guillemotmoussu/PX222-EIS/PDF/CarnetBord_3_MazzoneMoussu.pdf

### PROJET EIS - PX222

Guillemot MOUSSU et Rémi MAZZONE

2° semestre - 2022-2023

## Table des matières

1 Séance 0 - 21/03/2023 | 3
2 Séance 1 - 05/04/2023 | 4
3 Travail entre les séance 1 et 2 | 8
4 Séance 2 - 18/04/2023 | 10
5 Travail entre les séances 2 et 3 | 12
6 Séance 3 - 03/05/2023 | 14

6.2.2 | Calcul du point de fonctionnement | | 16
6.2.3 | Résistance de la bobine | | 17
6.2.4 | Inductance de la bobine | | 17
6.3 Conclusions | | 18
7 Bibliographie | 19

## Table des gures

1 | Notes séance 0 | | 3
2 | Modélisation de la bobine | | 4
3 | Bode obtenu | | 5
4 | Nyquist obtenu | | 5
5 | Schéma bloc du système | | 6
6 | Amplicateur à AOP | | 6
7 | Modélisation du bloc amplicateur | | 6
8 | Régulateur PD | | 7
9 | Modélisation du bloc régulateur (PD) | | 7
10 | Régulateur PID | | 7
11 | Modélisation complète avec retour (PD) | | 8
12 | Résulat idéal de la simulation | | 9
13 | Schéma LTSPICE de l'amplicateur | | 9
14 | Simulation de l'amplicateur | | 9
15 | Schéma bloc du système, version électronique numérique | | 10
16 | Brochage du STM8s discovery | | 10
17 | Bobine alimentée | | 16
18 | Courbe de l'intensité mesurée en fonction de la distance | | 16
19 | Mesure de la résistance | | 17
20 | Mesure de l'inductance | | 17
21 | Réponse de la bobine | | 17

## 1 Séance 0 - 21/03/2023

1.1 Notes prises au tableau

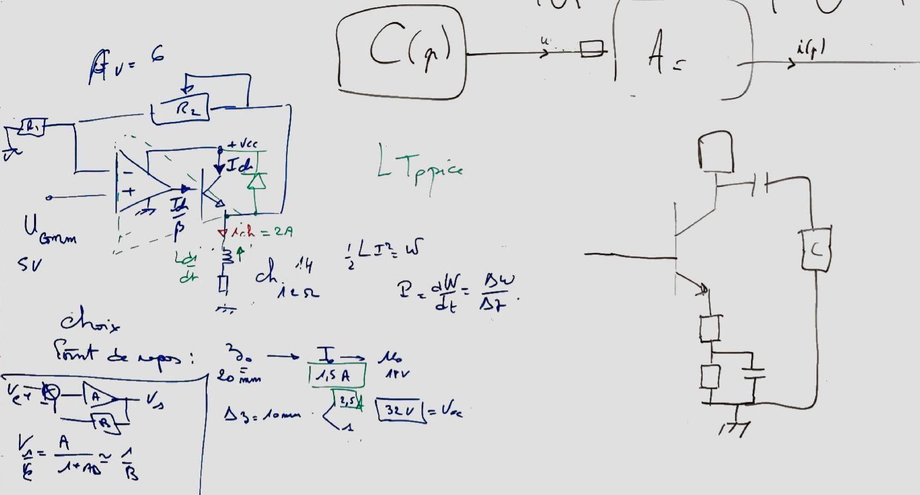
[picture p1: figure]

Figure 1 Notes séance 0

1.2 Idées de plan de recherches

Caractérisation de la bobine : mesure de la résistance et l'inductance de la bobine. Cela
| permettra de modéliser la bobine et de calculer le champ magnétique qu'elle produit
Modélisation de la bobine : utilisation des valeurs mesurées pour construire un modèle
| électrique de la bobine, par exemple en utilisant l'équation de l'inductance d'une bobine. Pour une précision plus élevée, il peut être nécessaire d'inclure d'autres eets tels que la saturation du noyau de la bobine ou la résistance série équivalente

Étude du champ magnétique de la bobine : calcul de la distribution du champ magnétique
| à l'aide d'un logiciel de simulation. Validation des résultats expérimentalement
Choix d'un capteur de distance : choix d'un capteur de distance infrarouge adapté à la
| plage de mesure et à la précision requises. La fréquence de mesure et la plage de mesure peuvent inuencer le résultat

Calibration du capteur de distance : déterminer la relation entre la tension de sortie du
| capteur et la distance de la bille par rapport à la bobine
Conception d'un correcteur : utiliser les données obtenues précédemment pour concevoir un
| correcteur proportionnel-intégral-dérivé (PID) ou un correcteur à avance de phase pour contrôler la position de la bille. C'est la partie clé de ce projet. Le correcteur PID est une méthode de contrôle classique qui est souvent utilisée pour les systèmes de positionnement. Un correcteur à avance de phase peut également être utilisé pour améliorer les performances.

Implémentation du correcteur : test du correcteur via Matlab et Simulink
Étalonnage du système : ajuster les paramètres du correcteur pour atteindre la précision et
| la stabilité requises
Validation du système : tester le système dans diérentes conditions et valider ses perfor-
| mances
Optimisation du système : améliorer le système en optimisant les paramètres du correcteur
| et en utilisant des techniques avancées de contrôle, telles que le contrôle prédictif et le contrôle adaptatif

Il est important de noter que certains des points ont déjà été réalisés lors du premier semestre

## 2 Séance 1 - 05/04/2023

2.1 Reprise des éléments du semestre précédent

Avec Hopkinson, nous avions obtenu un schéma équivalent de la bobine :

ε

φ

R1

R(z)

R0

Figure 2 Modélisation de la bobine

Nous avions trouvé que la fonction de transfert de la bobine est : TBO =

Z
I

=

ki
kz − mp²
Avec les valeurs suivantes :
I0 = 2A, Z0 = 22mm, L1 = 6.73H, α = 2.06, m = 35.8g

ki =

I0 · L1 · α
(1 + α · Z0)

2

, kz =

I

2/0· L1 · α

2
(1 + α · Z0)

3

2.2 Utilisation de Matlab

Nous avons donc notre fonction de transfert. Une idée qui nous est venue est d'adapter les scripts pour utiliser l'outil de M. Mendes que nous avons découvert en TP. Cela devrait nous permettre de calculer notre correcteur. Pour commencer, on a placé nos valeurs dans Matlab et tracé le bode obtenu. Cette étape est présente seulement pour nous faire une idée du système à l'heure actuelle

Code Matlab que nous avons utilisé :

1 | I0 = 2;
2 | Z0 = 22 * 10^-3;
3 | L1 = 6.73;
4 | alpha = 2.06;
5 | ki = (I0 * L1 * alpha) / (1 + alpha * Z0) ^2;
6 | kz = -(I0 ^2 * L1 * alpha ^2) / (1 + alpha * Z0) ^3;
7 | m = 35.8;

8
9 | num = ki ;
10 | den = [(-m) 0 kz];
11 | sys = tf(num,den);

12
13 | figure;
14 | bode(sys)
15 | grid on
16 | figure;
17 | nyquist(sys)
18 | grid on

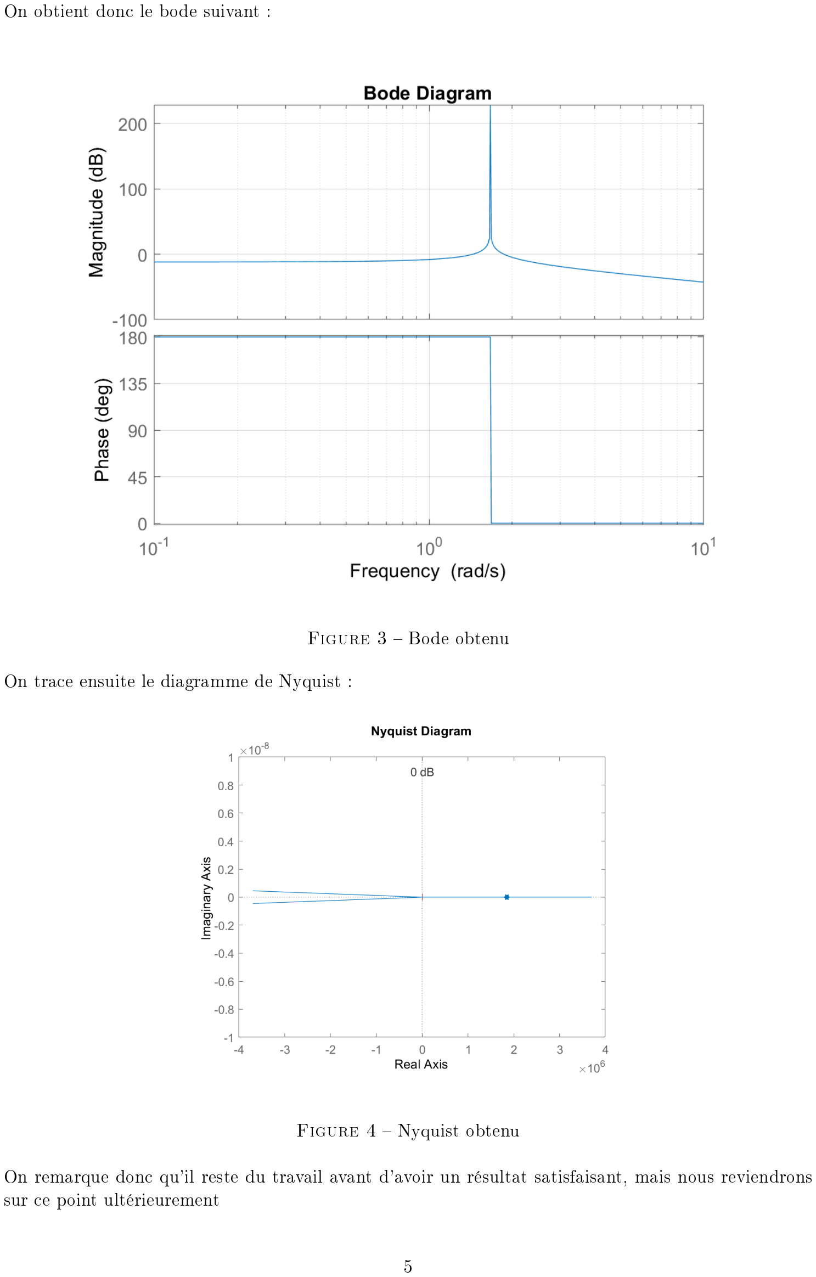
[picture p2: page 5]

On obtient donc le bode suivant :

Figure 3 Bode obtenu

On trace ensuite le diagramme de Nyquist :

Figure 4 Nyquist obtenu

On remarque donc qu'il reste du travail avant d'avoir un résultat satisfaisant, mais nous reviendrons sur ce point ultérieurement

2.3 Modélisation point par point du système

L'objectif est de réaliser un circuit correspondant à ce schéma bloc :

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
X | Y

B

Ym

Figure 5 Schéma bloc du système

### 2.3.1 Modélisation de l'amplicateur

Nous avons en sortie d'un STM8 un signal de 5V, nous voulons que la bobine soit alimentée en 30V. Pour cela on utilise un amplicateur à AOP, en série avec un transistor bipolaire. On a le schéma classique d'un amplicateur à AOP :

A

U | X

−

+

R1
U

R2

X

Figure 6 Amplicateur à AOP

Si on ajoute le transistor et la bobine au schéma, cela nous donne :

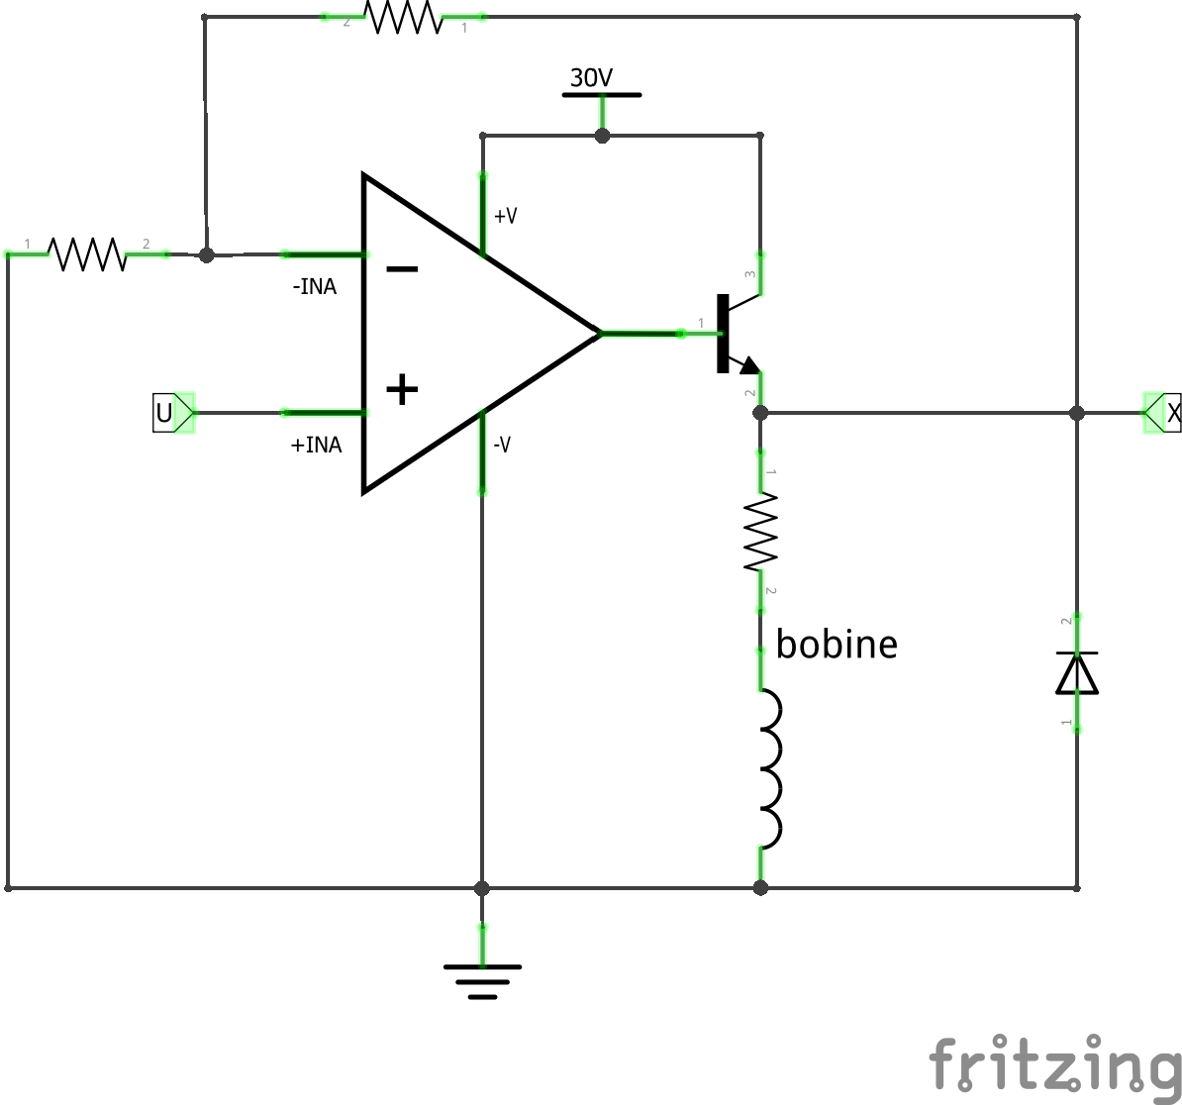
[picture p3: figure]

Figure 7 Modélisation du bloc amplicateur

### 2.3.2 Modélisation d'un régulateur PD

On a le schéma classique d'un régulateur PD :

R

ε | U

−

+

R1

ε

C
R2

U

Figure 8 Régulateur PD

Si on donne le schéma complet de ce bloc, cela nous donne :

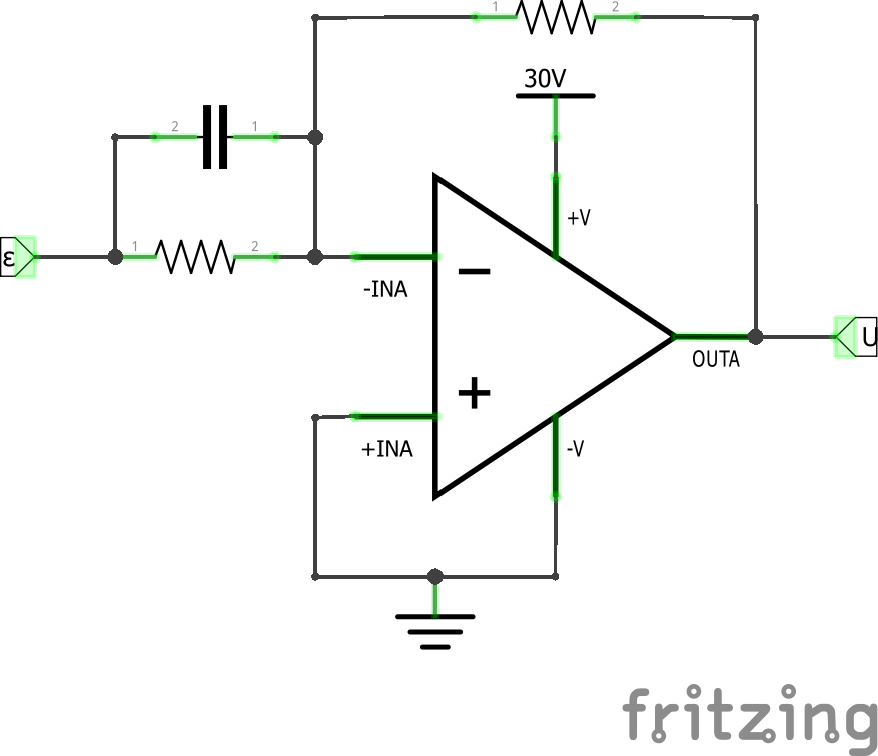
[picture p4: figure]

Figure 9 Modélisation du bloc régulateur (PD)

### 2.3.3 Modélisation d'un régulateur PID

Dans le cas où l'on souhaite nalement modéliser un régulateur PID, on doit ajouter un condensateur en parallèle de notre résistance :

−

+

R1

ε

C1 | R2

C2

U

Figure 10 Régulateur PID

### 2.3.4 Modélisation du système complet (PD)

On choisit le régulateur PD pour représenter le système complet. On a vu qu'il sura d'ajouter une capacité pour passer à un régulateur PID au besoin. On repère bien les blocs comparateur, amplicateur (A), régulateur (R) et capteur (B)

a

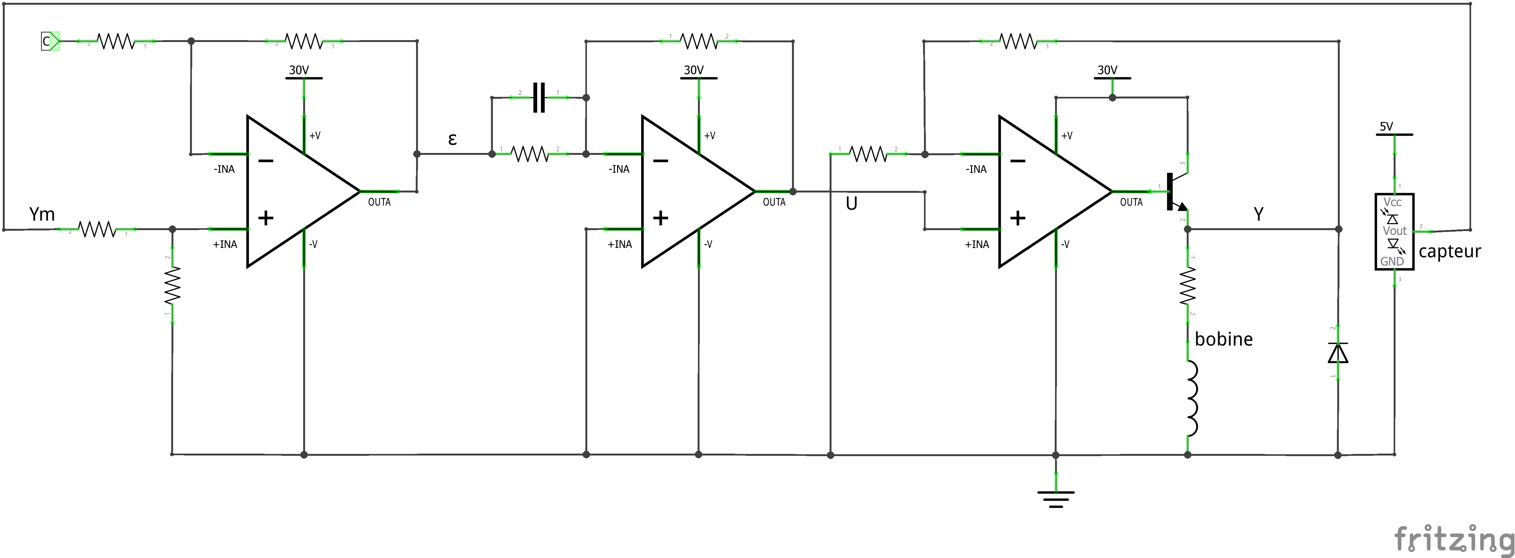
[picture p5: figure]

Figure 11 Modélisation complète avec retour (PD)

2.4 Conclusions pour cette séance

On commence à avoir des pistes intéressantes. Les schémas que nous avons réalisés vont nous permettre de se faire une idée du système à concevoir, et nous avons perçu l'importance d'utiliser Matlab pour nous aider dans nos calculs

## 3 Travail entre les séance 1 et 2

3.1 Correction des éléments de la séance précédente

Nous avions manqué de temps pour terminer comme nous le souhaitions certains points de la séance précédente. Nous avons travaillé sur les points suivants :

### 3.1.1 Matlab

Pour plus de détails se référer à la section 2.2

Les schémas avaient étés rendus avec Octave, mais après comparaison des rendus, ceux de Matbab donnent d'autres résultats. Les gures 3 et 4 ont donc été mises à jour

### 3.1.2 Modélisation point par point du système

Pour plus de détails se référer à la section 2.3

La gure 5 est maintenant rendue en LATEX

Pour plus de clarté, les points 2.3.1, 2.3.2 et 2.3.3 ont été repris. Les gures 6, 8 et 10 ont été reprises en LATEX. Les gures 7 et 9 ont été reprises sur Fritzing, avec un bloc AOP mis à jour

Le point 2.3.4 a été séparé plus plus de clarté. La gure 11 y a été ajoutée

3.2 Simulation de l'amplicateur

On veut donc simuler notre bloc amplicateur. Dans l'idéal on devrait avoir le graphique suivant :

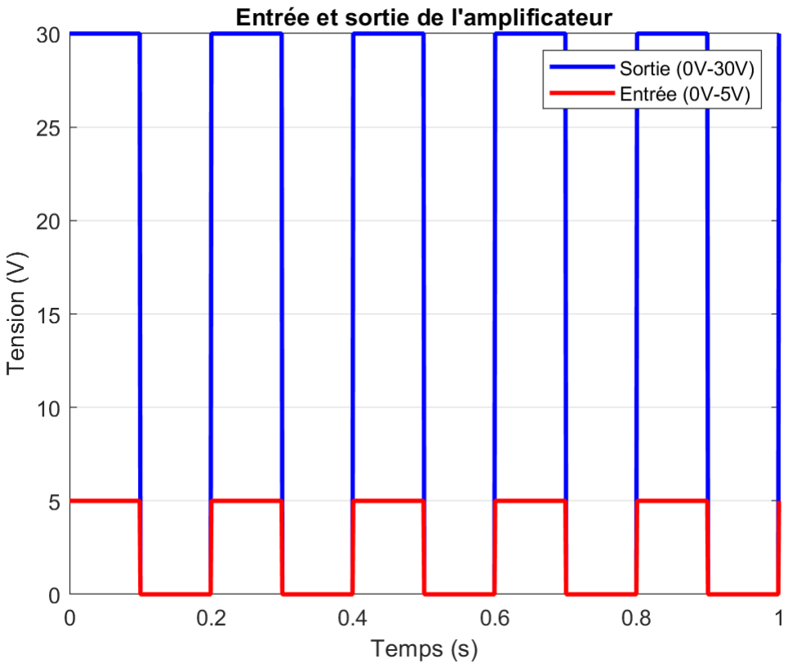
[picture p6: figure]

Figure 12 Résulat idéal de la simulation

On rentre donc le modèle suivant dans LTSPICE :

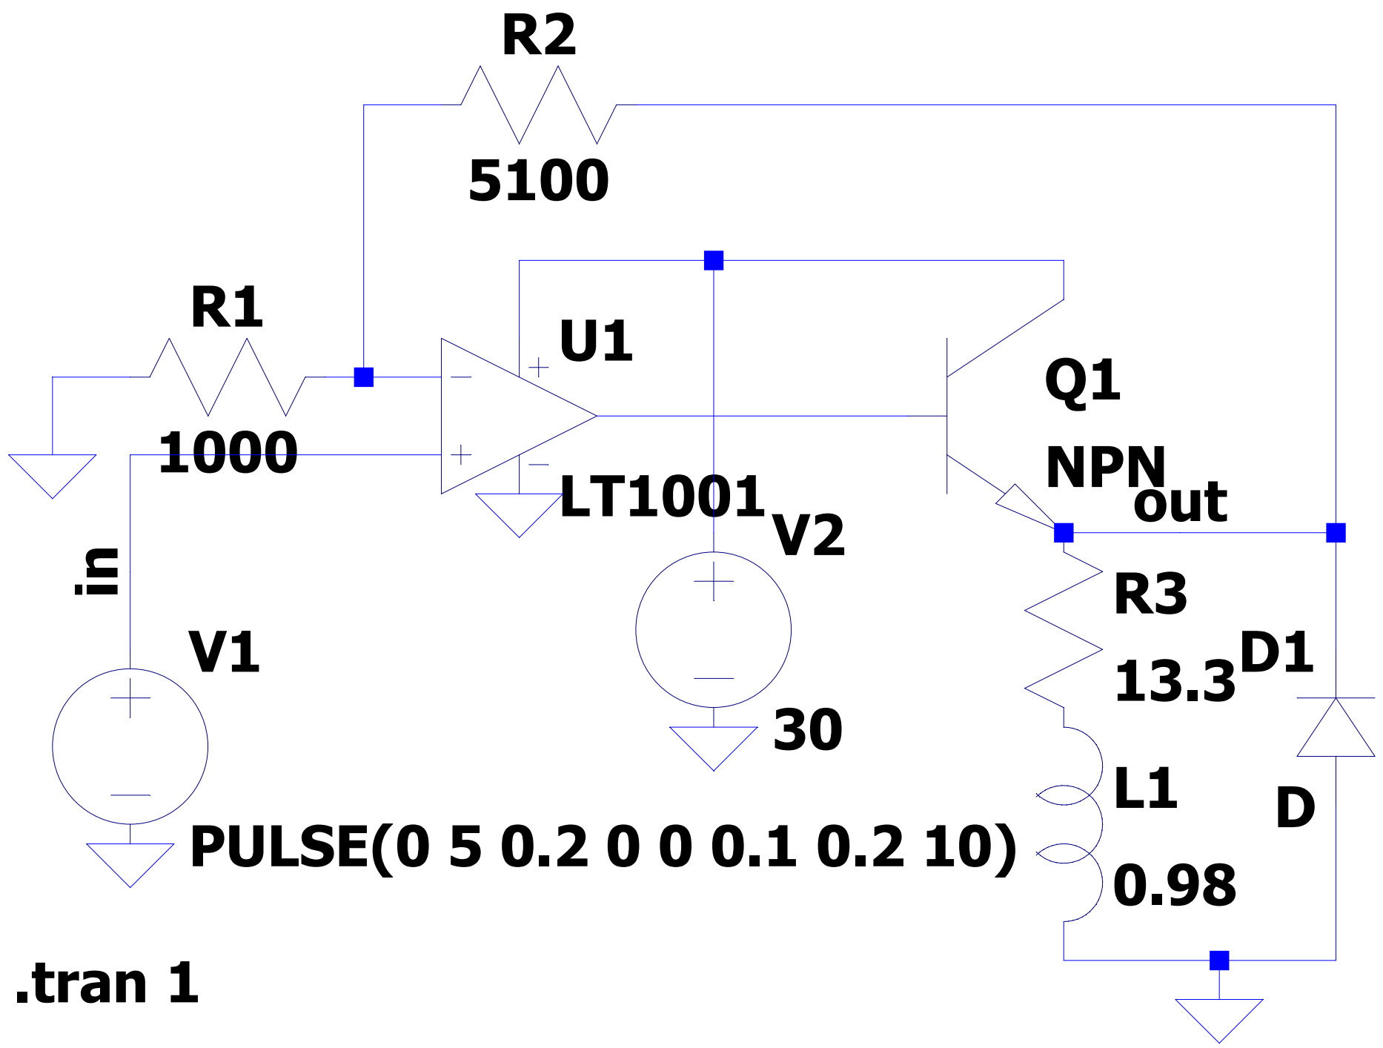
[picture p7: figure]

Figure 13 Schéma LTSPICE de l'amplicateur

Et on obtient le résultat suivant :

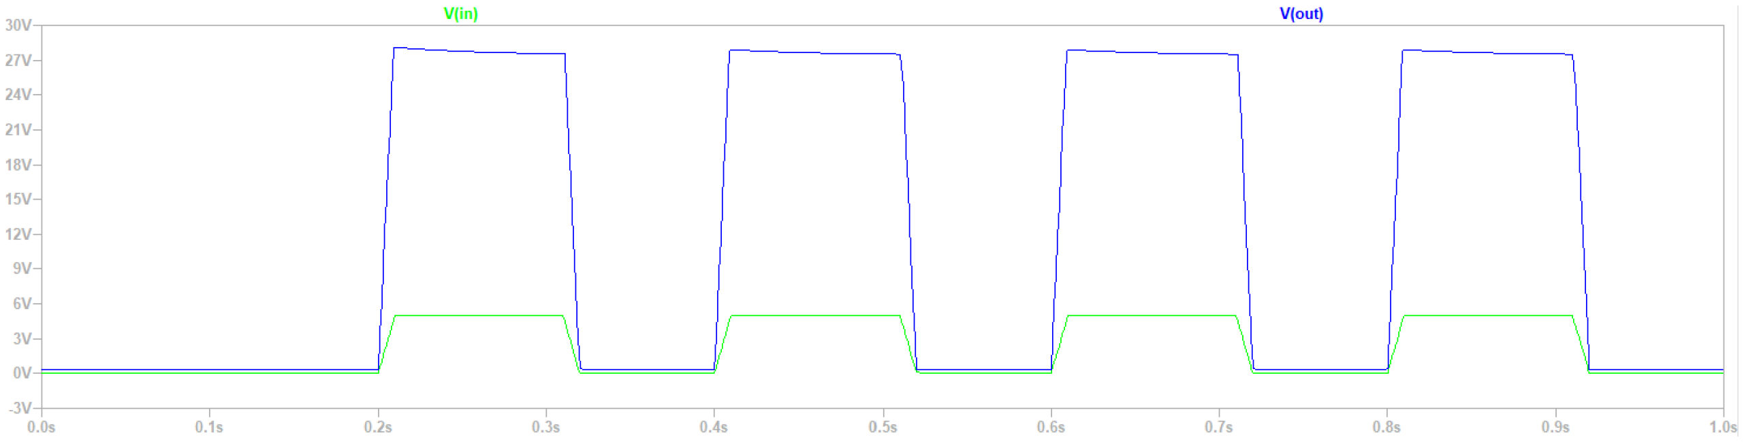
[picture p8: figure]

Figure 14 Simulation de l'amplicateur

### Remarques :

On a utilisé un AOP quelconque (le LT1001 en l'occurence)
On a utilisé les mesures de la bobine du S1 (R = 13.3Ω et L = 0.98H)
On a utilisé un transistor quelconque
On remarque que la simulation correspond au modèle théorique voulu. C'est bon signe pour la suite, il reste à le tester avec des composants réels

## 4 Séance 2 - 18/04/2023

4.1 Réexion sur la numérisation du correcteur

On va donc chercher à numériser la partie correcteur. Cela correspond aux éléments suivants sur notre schéma bloc :

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
X | Y

B

Ym

Figure 15 Schéma bloc du système, version électronique numérique

On utilisera un STM8s pour la numérisation. On compte utiliser un port analog input pour l'entrée venant du capteur, et un port I/O piloté en PWM pour la sortie U

4.2 Prise en main du STM8s

On a le brochage du STM8 :

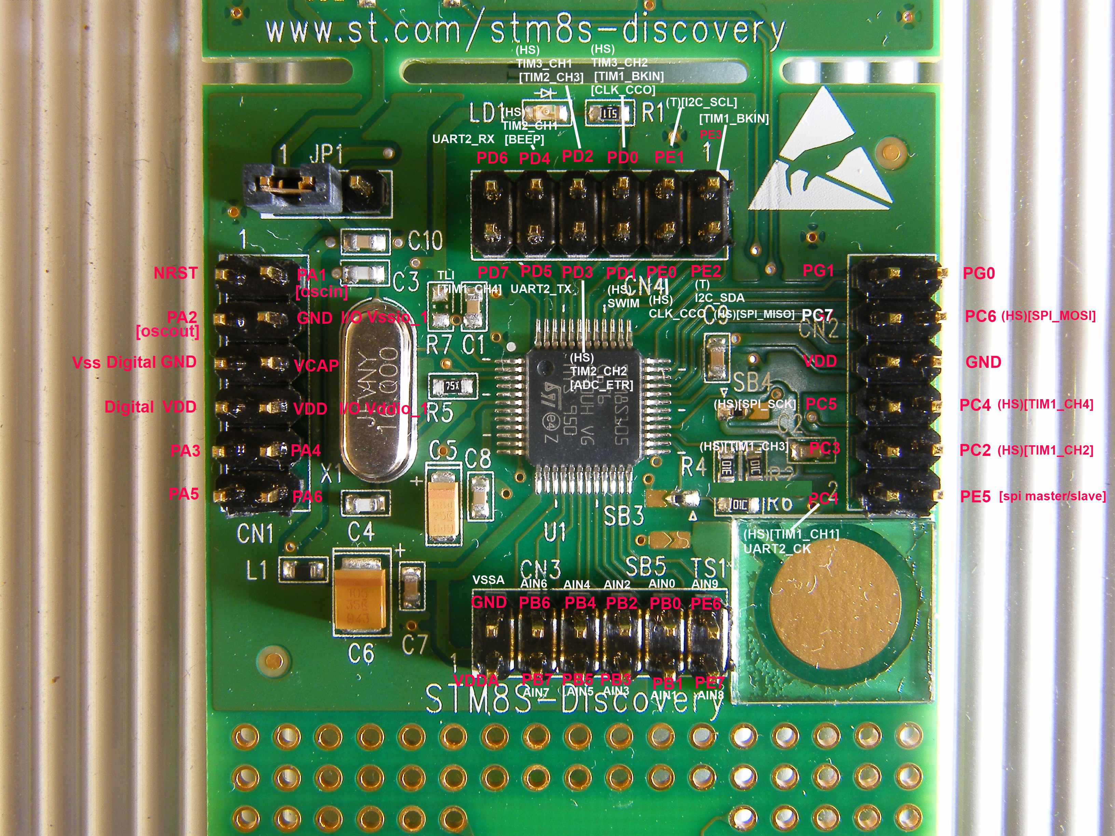
[picture p9: figure]

Figure 16 Brochage du STM8s discovery

On dénit pour le moment qu'on utilise le port B0 (Analog 0) pour l'entrée et le port G0 pour la sortie (I/O classique)

4.3 Premier essai de code

Par la suite, nous avons cherché à faire fonctionner la carte, en vue de pouvoir faire nos mesures. On se base sur l'exemple fourni par ST permettant de faire clignoter la LED installée sur la carte : chiers du projet. (https://www.st.com/en/embedded-software/stsw-stm8023.html) Ce projet est écrit en C, compilé à l'aide de Cosmic. On conrme que cela fonctionne

4.4 Essais avec Arduino

An de pouvoir communiquer, notemment via la communication série avec la carte, on a essayé d'ins-taller les librairies nécessaires sur l'Arduino IDE. On se base sur le travail de Michael Mayer pour le

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

Le but de ce code est de réaliser les actions suivantes :
Toutes les 10ms, une interruption se produit et déclenche la conversion ADC, et attend la n de la conversion
La valeur de la conversion est stockée dans le registre TIM4_ARR, qui est utilisé pour dénir la période du timer 4
En tant que tel, on peut ensuite utiliser un oscilloscope pour acher la tension mesurée

Nous n'avons pas eu le temps de rééchir au code, et nous ne savons pas encore si nous préfèrerons le faire en assembleur ou en C

4.6 Conclusions pour cette séance

Si nous avons pu prendre en main la carte et rééchir à l'implémentation du correcteur numériquement, les nombreux freins (problèmes logiciels, logiciels peu ergonomiques...) ont été un frein et nous n'avons pas eu le temps de faire beaucoup de choses. Il sera donc important de travailler entre les deux prochaines séances pour avancer, tant sur la partie analogique, que la partie numérique

## 5 Travail entre les séances 2 et 3

5.1 Lecture d'une entrée analogique

Des recherches sur internet nous ont permis de trouver les tutoriels suivants : Tutoriel de CircuitDigest pour ADC (https://circuitdigest.com/microcontroller-projects/adc-on-stm8s-using-c-compiler-reading-multiple-adc-values-and-displaying-on-lcd) et Tutoriel de CircuitDigest pour la lecture série. (https://circuitdigest.com/microcontroller-projects/serial-monitor-on-stm8s-using-cosmic-and-stvd) On utilise le code de ces deux tutoriels pour produire le programme suivant :

#include "STM8S.h"

#include "stm8s103_adc.h"

#include "stm8s103_serial.h"

void main()

{
| // Declarations de variables unsigned int ADC_value_1 = 0; int ADC_voltage_1 = 0;
| CLK_PeripheralClockConfig(CLK_PERIPHERAL_ADC, ENABLE); // Activer l'horloge peripherique pour l'ADC GPIO_Init(GPIOB, GPIO_PIN_0, GPIO_MODE_IN_FL_IT); // Initialiser le pin PB0 en entree
| Serial_begin(9600); Serial_print_string("Bonjour !"); Serial_newline(); delay_ms(5000);
| while (1)

{
| ADC_value_1 = ADC_Read(AIN2); ADC_voltage_1 = ADC_value_1 * (2.933); //(3000/1023 =~ 2.933) Serial_print_string("B0: "); Serial_print_string(ADC_value_1); Serial_print_string(" -> "); Serial_print_string(ADC_voltage_1); Serial_print_string(" mV"); Serial_newline(); delay_ms(500);

}

}

On aura donc à priori besoin des chiers suivants : Fichiers de base (https://github.com/CircuitDigest/STM8S103F3_SPL)
Fichier Serial.h (https://github.com/CircuitDigest/STM8S103F3_SPL/blob/master/stm8s103%20Libraries/stm8s103_Serial.h)
Fichier ADC.h (https://github.com/CircuitDigest/STM8S103F3_SPL/blob/master/inc/stm8s103_ADC.h)

5.2 Génération d'un signal PWM

### 5.2.1 Code

Des recherches sur internet nous ont permis de trouver le tutoriel suivant : Tutoriel de CircuitDigest. (https://circuitdigest.com/microcontroller-projects/pulse-width-modulation-pwm-with-stm8-using-cosmic-c-and-stvd) On en retire le code suivant :

#include "STM8S.h"

void delay_ms(int ms)

{
int i;
int j;
| for (i = 0; i <= ms; i++) { for (j = 0; j < 120; j++) {_asm("nop");}

}

}

void main(void)

{
| GPIO_DeInit(GPIOD); TIM2_DeInit(); GPIO_Init(GPIOD, GPIO_PIN_4, GPIO_MODE_OUT_PP_HIGH_FAST); TIM2_OC1Init(TIM2_OCMODE_PWM1, TIM2_OUTPUTSTATE_ENABLE, 1000, TIM2_OCPOLARITY_HIGH); TIM2_TimeBaseInit(TIM2_PRESCALER_1, 500); TIM2_Cmd(ENABLE); while (TRUE)

{
| signed int pwm_duty = 500; TIM2_SetCompare1(pwm_duty);

}

}

### 5.2.2 Description du code

Dans la fonction main, les fonctions de conguration et d'initialisation suivantes sont appelées :
GPIO_DeInit(GPIOD) : réinitialisation des paramètres du port D
TIM2_DeInit() : réinitialisation du Timer 2
{GPIO_Init(GPIOD, GPIO_PIN_4, GPIO_MODE_OUT_PP_HIGH_FAST) : conguration de la broche PD4
| en sortie push-pull avec une vitesse élevée
TIM2_OC1Init(...) : conguration du Timer 2 pour générer un signal PWM en mode 1 avec un
| rapport cyclique initial de 1000 (50%)
TIM2_TimeBaseInit(TIM2_PRESCALER_1, 500) : conguration de la base de temps du Timer 2
| avec un prédiviseur de 1 et une valeur d'autorechargement de 500
TIM2_Cmd(ENABLE) : activation du Timer 2

Enn, la partie :

1 | while (TRUE)
2 | {
3 | signed int pwm_duty = 500;
4 | TIM2_SetCompare1(pwm_duty);
5 | }

Génère un signal PWM de rapport cyclique (pwm_duty/10)%

### 5.2.3 Fichiers nécessaires

Comme précedemment, on aura besoin des chiers des Fichiers de base (https://github.com/CircuitDigest/STM8S103F3_SPL)

## 6 Séance 3 - 03/05/2023

6.1 Partie électronique numérique

### 6.1.1 Récupération d'une entrée

Nous auront donc un capteur renvoyant des valeurs entre 0V et 3V , correspondant à la distance avec la bille, dont il faudra récupérer les valeurs à l'aide d'un port analogique du STM8. Nous souhaitions récupérer les valeurs et les renvoyer vers un port série. Cependant, malgré l'installation de drivers et des bibliothèques nécessaires, que ce soit avec le moniteur Arduino ou avec Putty, nous n'avons pas réussi à récupérer les valeurs renvoyées par la carte. Le code que nous avions écrit plus haut compile cependant, et la carte arrive à l'exécuter. Nous pourrons vérier son fonctionnement lorsque nous auront réussi à générer des signaux PWM.

### 6.1.2 Génération de signaux PWM

Nous avons donc tenté de générer des signaux PWM en utilisant notre code. Lorsque le programme est exécuté, on constate bien une tension entre PD4 et la masse, mais cette tension est constante. Nous avons tenté de nombreuses modications sans succès. Nous avons donc voulu essayer des exemples présents en ligne, an d'au moins se faire une idée sur la faisabilité de la génération de ces signaux. Voici une liste des sites que nous avons utilisé, ainsi que le résultat que nous avons pu obtenir au nal :

Site de ST Microelectronics (https://www.st.com/en/embedded-software/stsw-stm8036.html) : ne contient pas un programme complet, ne compile pas, pas de résultats concluants
Site de CircuitDigest (https://circuitdigest.com/microcontroller-projects/pulse-width-modulation-pwm-with-stm8-using-cosmic-c-and-stvd) : code dont nous nous étions inspiré, génère une tension positive constante mais pas de PWM
Site de Mark-Stevens (https://blog.mark-stevens.co.uk/2012/08/generating-pwm-signals-using-the-stm8s/) : ne contient pas les chiers nécessaire à la compilation, pas de résultats concluants
Site d'Embedded lab (https://embedded-lab.com/blog/starting-stm8-microcontrollers/20/) : compile avec quelques modications, mais pas de tension en sortie des ports de la carte
Github de stecman (https://gist.github.com/stecman/f748abea0332be1e41640fd25b5ca861) : nous n'avons pas eu le temps de regarder, mais semble intéressant
Au nal nous n'avons pas encore de résultats. Il faudra par la suite soit trouver pourquoi nous n'arri-vons pas à générer ces signaux avec un programme en C, soit essayer en assembleur. Le problème de l'assembleur est qu'il sera probablement plus dicile d'implémenter nos calculs de PID.

### 6.1.3 Brouillon pour un régulateur P

En parallèle, nous avons commencé à rééchir à un programme permettant de récupérer l'entrée, d'appliquer un calcul (ici Kp = 1), et de produire une sortie avec un signal PWM. Ce code n'a pas encore été testé.

#include "stm8s.h"

#include "stm8s_adc1.h"

#include "stm8s_tim1.h"

// Parametre du regulateur proportionnel #define KP 1.0

// Variables globales
volatile uint16_t consigne = 0; volatile uint16_t adc_value = 0;

void main(void) {
// Initialisation des peripheriques (ADC, TIM1, etc.) System_Init();

while (1) {
adc_value = ADC1_GetConversionValue(); // Lecture de la valeur ADC regulation_P(); // Appel de la fonction de regulation proportionnelle

}

}

void System_Init() {
// Configuration ADC
ADC1_Init(ADC1_CONVERSIONMODE_SINGLE, ADC1_CHANNEL_0, ADC1_PRESSEL_FCPU_D2, ADC1_EXTTRIG_TIM, DISABLE, ADC1_ALIGN_RIGHT, ADC1_SCHMITTTRIG_CHANNEL0, DISABLE); ADC1_StartConversion();

// Configuration TIM1 pour PWM
TIM1_TimeBaseInit(0xFFFF, TIM1_COUNTERMODE_UP, 0, 0); TIM1_OC1Init(TIM1_OCMODE_PWM1, TIM1_OUTPUTSTATE_ENABLE, 0, TIM1_OCPOLARITY_HIGH); TIM1_Cmd(ENABLE);
TIM1_CtrlPWMOutputs(ENABLE);

// Configuration du GPIO pour la sortie PWM GPIO_Init(GPIOB, GPIO_PIN_0, GPIO_MODE_OUT_PP_HIGH_FAST);

// Configuration du GPIO pour l'entree analogique (ADC) GPIO_Init(GPIOA, GPIO_PIN_0, GPIO_MODE_IN_FL_NO_IT);

}

// Fonction de mise a jour de la consigne
void set_consigne(uint16_t value) { consigne = value;

}

// Fonction de regulation proportionnelle
void regulation_P() {
float erreur = (float)consigne - (float)adc_value;
float sortie = KP * erreur;

// Limiter la sortie entre 0 et la valeur maximale du compteur (ici 0xFFFF) if (sortie < 0) {
sortie = 0;
} else if (sortie > 0xFFFF) {
sortie = 0xFFFF;

}

// Mise a jour de la sortie PWM TIM1_SetCompare1((uint16_t)sortie);

}

6.2 Partie électronique analogique

### 6.2.1 Matériel utilisé

On utilise la bobine n°3
On utilise la boule "38" pesant 37.6g et mesurant 49.74mm de diamètre

### 6.2.2 Calcul du point de fonctionnement

On commence par relier la bobine à l'alim :

28V

R

L

Bobine

Figure 17 Bobine alimentée

On a donc V = 28V , et on souhaite mesurer I en fonction z (distance entre le bas de la bobine et le centre de la boule)

On relève les valeurs suivantes :

Hauteur z | Courant I
0.0330m | 0.542A
0.0375m | 0.702A
0.0434m | 0.922A
0.0462m | 1.112A
0.0527m | 1.342A
0.0555m | 1.431A
0.0588m | 1.601A
0.0613m | 1.822A
0.0623m | 1.851A
0.0626m | 1.952A

On souhaite obtenir une interpolation ane de ces valeurs. On rentre dans MATLAB la commande polyfit(z,I,1); et on obtient que :

I = 45.8215z − 1.0243

On produit donc la courbe suivante :

3.5 | 4 | 4.5 | 5 | 5.5 | 6 ·10⁻²

0

0.5

1

1.5

2

Hauteur z (m)

Courant

I (A)

Intensité mesurée

Interpolation ane

Figure 18 Courbe de l'intensité mesurée en fonction de la distance

Au nal, on choisit I0 = 1.8A, ce qui nous donne z0 = 0.062m

### 6.2.3 Résistance de la bobine

On réalise le montage suivant :

28V

A

i

R

L

Bobine

V

Figure 19 Mesure de la résistance

Après avoir patienté un moment, pour laisser le temps aux caractéristiques de la bobine d'être stables, on mesure U = 27.57V et I = 1.95A
On obtient donc la résistance de la bobine R = 14.1Ω

### 6.2.4 Inductance de la bobine

On réalise le montage suivant :

2V

1Hz

R

L

Bobine

Figure 20 Mesure de l'inductance

Après avoir patienté un moment, pour laisser le temps aux caractéristiques de la bobine d'être stables, on mesure un déphase φ = 150°

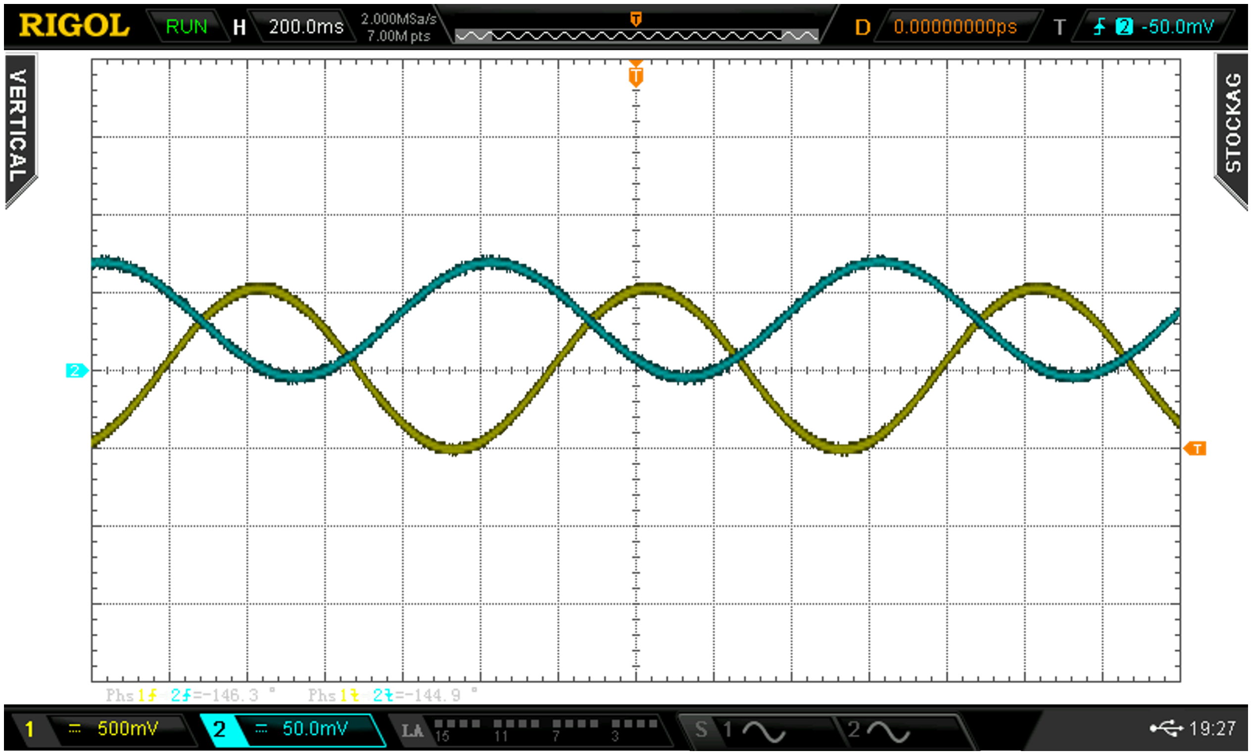
[picture p10: figure]

Figure 21 Réponse de la bobine

On calcule donc que l'inductance de la bobine vaut −

R · tan φ
2πf = −

14.1 · tan 150
2π

= 1.296H

6.3 Conclusions

Si nous avons peu avancé sur la partie numérique, nous avons pu caractériser la bobine, ce qui nous servira pour la suite dans la modélisation précise de notre système

## 7 Bibliographie

Liste des sites utilisés pour la réalisation du projet : Overleaf, guide d'utilisation du LATEX (https://www.overleaf.com/learn)
ChatGPT, modèle de langage automatisé (https://chat.openai.com/chat)
Manuel de Circuitikz (https://ctan.mines-albi.fr/graphics/pgf/contrib/circuitikz/doc/circuitikzmanual.pdf)
Manuel des Schéma-blocs avec PGF/TIKZ (https://sciences-indus-cpge.papanicola.info/IMG/pdf/schemabloc.pdf) Manuel des Schéma-blocs avec PGF/TIKZ (https://sciences-indus-cpge.papanicola.info/IMG/pdf/schemabloc.pdf) Tutoriels de CircuitDigest pour STM8s (https://circuitdigest.com/microcontroller-projects/getting-started-with-stm8s-using-stvd-and-cosmic-c-compiler)
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
