guillemotmoussu/PX222-EIS/PDF/CarnetBord_1_MazzoneMoussu.pdf

### PROJET EIS - PX222

Guillemot MOUSSU et Rémi MAZZONE

2° semestre - 2022-2023

## Table des matières

1 Carnet de bord des séances | 2
1.1 Séance 0 - 21/03/2023 | | 2
1.1.1 | Notes prises au tableau | | 2
1.1.2 | Idées de plan de recherches | | 2
1.2 Séance 1 - 05/04/2023 | | 3
1.2.1 | Reprise des éléments du semestre précédent | | 3
1.2.2 | Utilisation de Matlab | | 3
1.2.3 | Schémas du système | | 5
1.2.4 | Conclusions pour cette séance | | 7
2 Bibliographie | 8

## Table des gures

1 | Notes séance 0 | | 2
2 | Modélisation de la bobine | | 3
3 | Bode obtenu | | 4
4 | Nyquist obtenu | | 4
5 | Schéma bloc du système | | 5
6 | Ampli classique à AOP | | 5
7 | Ampli et régulateur PD | | 5
8 | Ampli, régulateur PD et retour | | 6
9 | Ampli et régulateur PID | | 6
10 | Ampli, régulateur PID et retour | | 7

## 1 Carnet de bord des séances

### 1.1 Séance 0 - 21/03/2023

### 1.1.1 Notes prises au tableau


Figure 1 Notes séance 0

### 1.1.2 Idées de plan de recherches

Caractérisation de la bobine : mesure de la résistance et l'inductance de la bobine. Cela permettra de modéliser la bobine et de calculer le champ magnétique qu'elle produit
Modélisation de la bobine : utilisation des valeurs mesurées pour construire un modèle électrique de la bobine, par exemple en utilisant l'équation de l'inductance d'une bobine. Pour une précision plus élevée, il peut être nécessaire d'inclure d'autres eets tels que la saturation du noyau de la bobine ou la résistance série équivalente
Étude du champ magnétique de la bobine : calcul de la distribution du champ magnétique à l'aide d'un logiciel de simulation. Validation des résultats expérimentalement
Choix d'un capteur de distance : choix d'un capteur de distance infrarouge adapté à la plage de mesure et à la précision requises. La fréquence de mesure et la plage de mesure peuvent inuencer le résultat
Calibration du capteur de distance : déterminer la relation entre la tension de sortie du capteur et la distance de la bille par rapport à la bobine
Conception d'un correcteur : utiliser les données obtenues précédemment pour concevoir un correcteur proportionnel-intégral-dérivé (PID) ou un correcteur à avance de phase pour contrôler la position de la bille. C'est la partie clé de ce projet. Le correcteur PID est une méthode de contrôle classique qui est souvent utilisée pour les systèmes de positionnement. Un correcteur à avance de phase peut également être utilisé pour améliorer les performances.
Implémentation du correcteur : test du correcteur via Matlab et Simulink
Étalonnage du système : ajuster les paramètres du correcteur pour atteindre la précision et la stabilité requises
Validation du système : tester le système dans diérentes conditions et valider ses performances

Optimisation du système : améliorer le système en optimisant les paramètres du correcteur et en utilisant des techniques avancées de contrôle, telles que le contrôle prédictif et le contrôle adaptatif

Il est important de noter que certains des points ont déjà été réalisés lors du premier semestre

### 1.2 Séance 1 - 05/04/2023

### 1.2.1 Reprise des éléments du semestre précédent

Avec Hopkinson, nous avions obtenu un schéma équivalent de la bobine :

ε

φ

R1

R(z)

R0

Figure 2 Modélisation de la bobine

Nous avions trouvé que la fonction de transfert de la bobine est : TBO =

Z
I

=

ki
kz − mp²
Avec les valeurs suivantes :
I0 = 2A, Z0 = 22mm, L1 = 6.73H, α = 2.06, m = 35.8g

ki =

I0 · L1 · α
(1 + α · Z0)

2

, kz =

I

2/0· L1 · α

2
(1 + α · Z0)

3

### 1.2.2 Utilisation de Matlab

Nous avons donc notre fonction de transfert. Une idée qui nous est venue est d'adapter les scripts pour utiliser l'outil de M. Mendes que nous avons découvert en TP. Cela devrait nous permettre de calculer notre correcteur. Pour commencer, on a placé nos valeurs dans Matlab et tracé le bode obtenu. Cette étape est présente seulement pour nous faire une idée du système à l'heure actuelle

Code Matlab que nous avons utilisé :

I0 = 2 ;
Z0 = 22 * 10^=3;
L1 = 6 . 7 3 ;
alpha = 2 . 0 6 ;
ki = ( I0 * | L1 * | alpha ) / (1 + alpha * | Z0 ) ^2;
kz = =( I0 ^2 * | L1 * | alpha ^2) / (1 + alpha * | Z0 ) ^3;
m = 3 5 . 8 ;

B = [ ki ]
A = [(=m) 0 kz ]

s y s = t f (B,A ) ;

f igure ;
bode ( s y s )
f igure ;
n y q ui s t ( s y s )

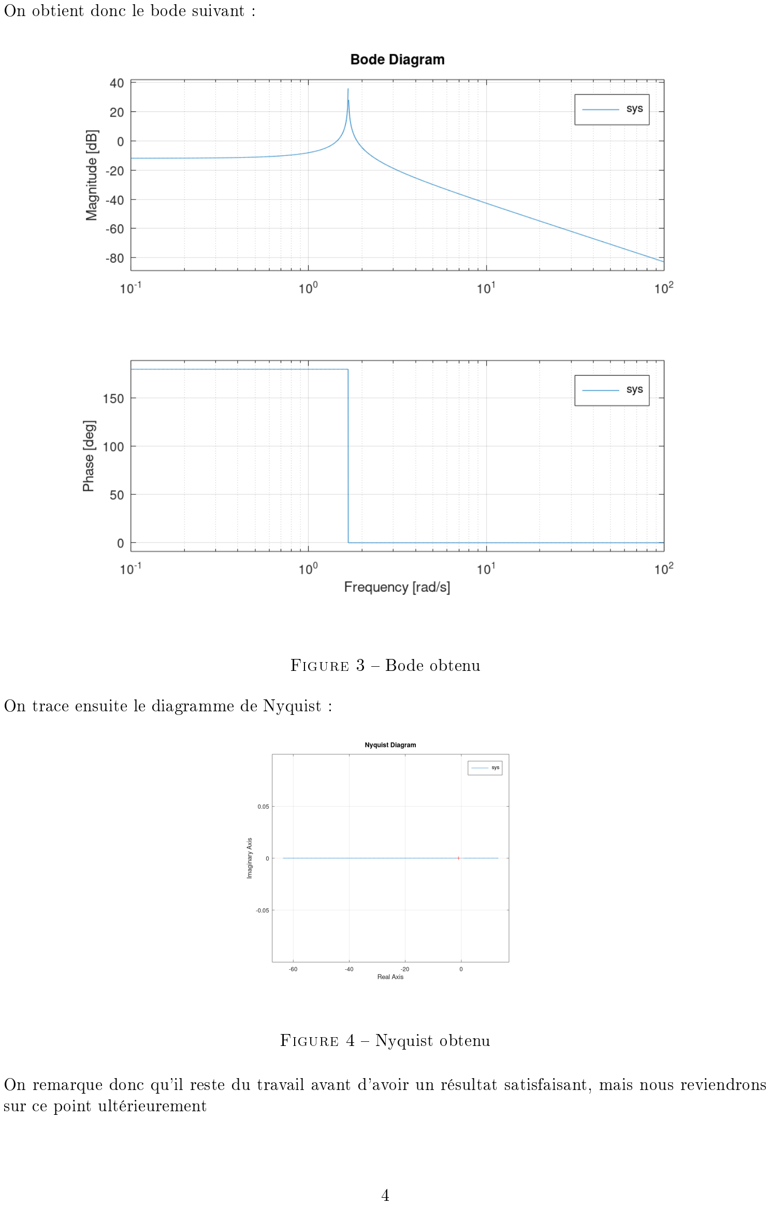
[picture p11: page 4]

On obtient donc le bode suivant :

Figure 3 Bode obtenu

On trace ensuite le diagramme de Nyquist :

Figure 4 Nyquist obtenu

On remarque donc qu'il reste du travail avant d'avoir un résultat satisfaisant, mais nous reviendrons sur ce point ultérieurement

### 1.2.3 Schémas du système

L'objectif est de réaliser un circuit correspondant à ce schéma bloc :

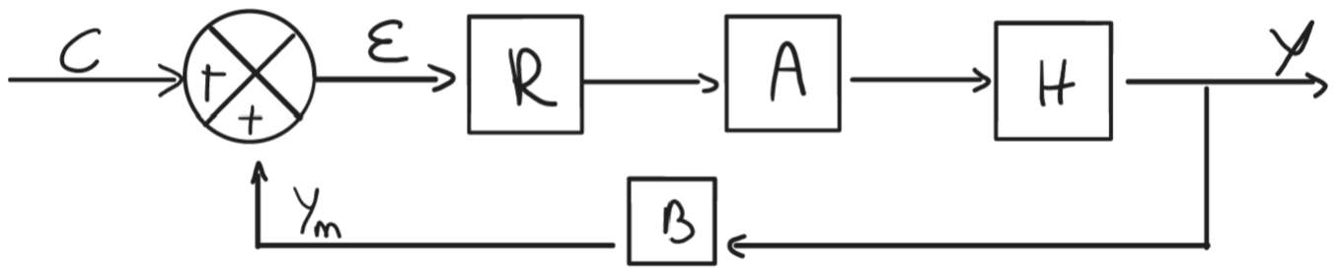
[picture p12: figure]

Figure 5 Schéma bloc du système

### Modélisation de l'ampli :

On utilise un AOP pour amplier le signal, le schéma du montage est le suivant :

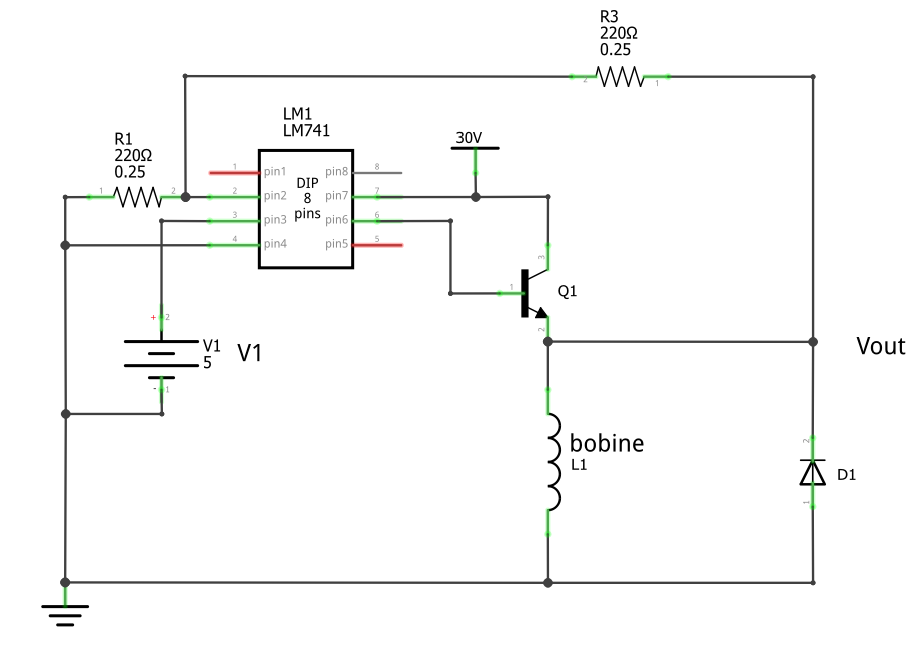
[picture p13: figure]

Figure 6 Ampli classique à AOP

### Modélisation d'un régulateur PD :

Dans le cas où l'on souhaite modéliser un régulateur PD, on ajoute les composants suivant après l'ampli :

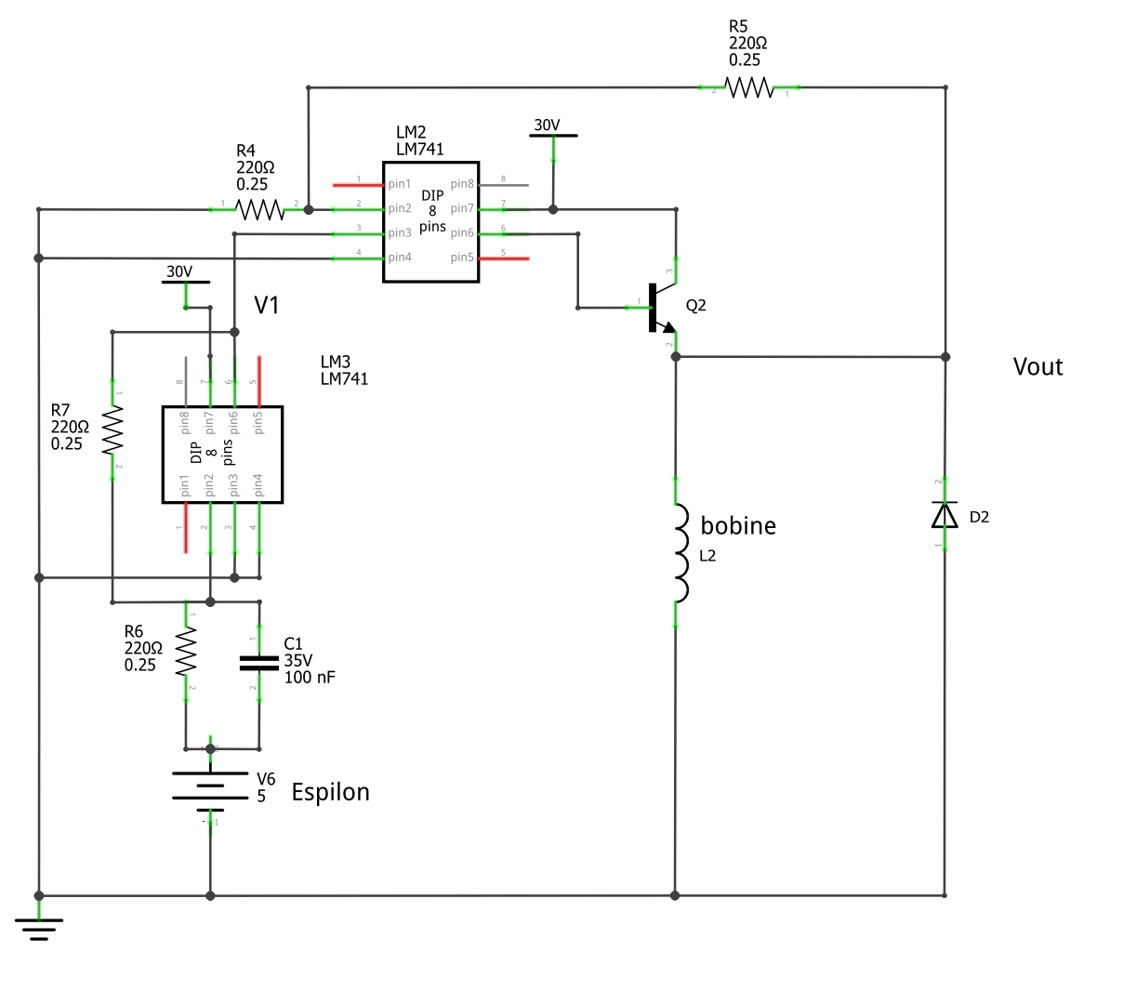
[picture p14: figure]

Figure 7 Ampli et régulateur PD

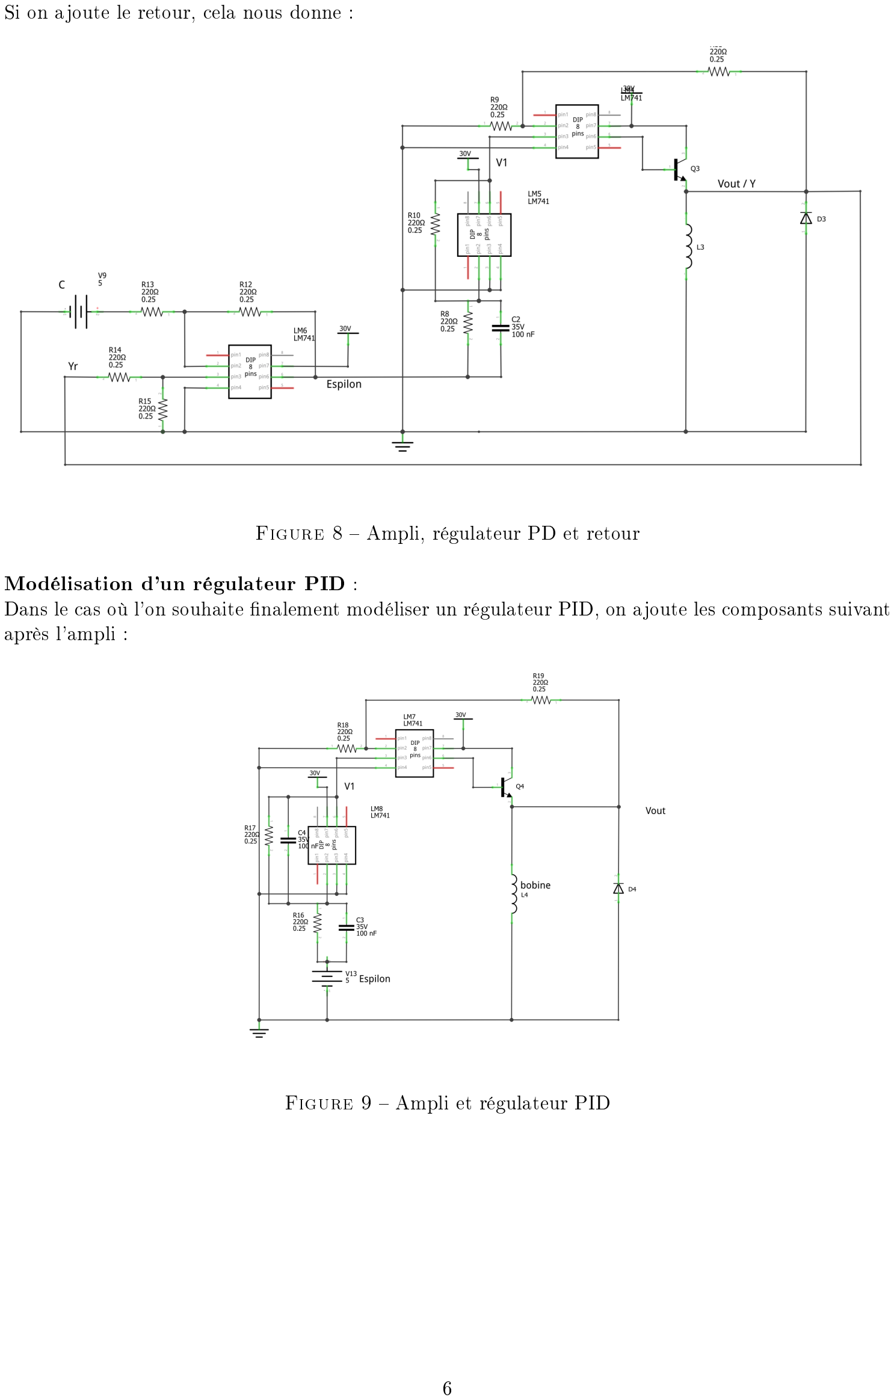
[picture p15: page 6]

Si on ajoute le retour, cela nous donne :

Figure 8 Ampli, régulateur PD et retour

### Modélisation d'un régulateur PID :

Dans le cas où l'on souhaite nalement modéliser un régulateur PID, on ajoute les composants suivant après l'ampli :

Figure 9 Ampli et régulateur PID

Si on ajoute le retour, cela nous donne :

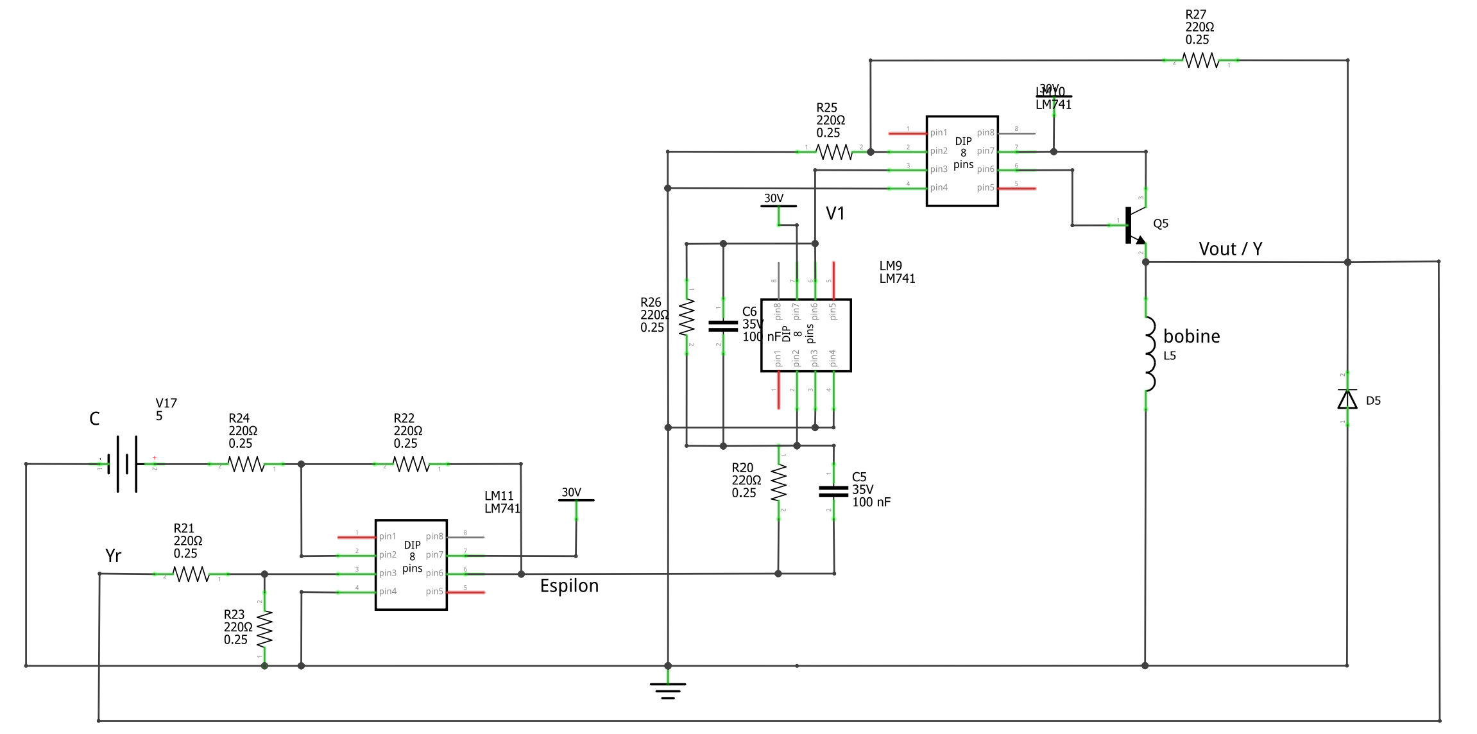
[picture p16: figure]

Figure 10 Ampli, régulateur PID et retour

### 1.2.4 Conclusions pour cette séance

On commence à avoir des pistes intéressantes. Les schémas que nous avons réalisés vont nous permettre de se faire une idée du système à concevoir, et nous avons perçu l'importance d'utiliser Matlab pour nous aider dans nos calculs

## 2 Bibliographie

Liste des sites utilisés pour la réalisation du projet :
| Overleaf, guide d'utilisation du LATEX (https://www.overleaf.com/learn) ChatGPT, modèle de langage automatisé (https://chat.openai.com/chat) Manuel de Circuitikz (https://ctan.mines-albi.fr/graphics/pgf/contrib/circuitikz/doc/circuitikzmanual.pdf)
