guillemotmoussu/PX222-EIS/Schémas/Correcteur PID.png

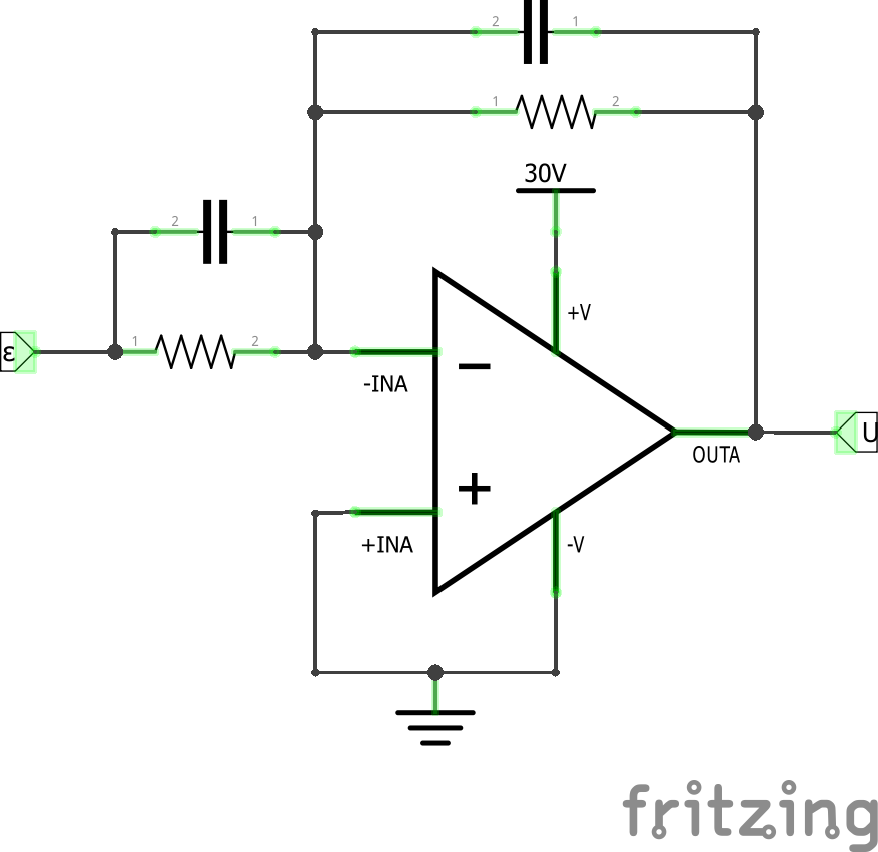
Schémas/Correcteur PID.png
