guillemotmoussu/PX222-EIS/(list of files, cad)

Other CAD files:
Numérisation/Librairies ST/STM8S_StdPeriph_Lib/Project/STM8S_StdPeriph_Template/STVD/Cosmic/stm8s903.stp
Numérisation/Librairies ST/STM8S_StdPeriph_Lib/Project/STM8S_StdPeriph_Template/STVD/Raisonance/stm8af52ax.stp
Numérisation/Librairies ST/STM8S_StdPeriph_Lib/Project/STM8S_StdPeriph_Template/STVD/Cosmic/stm8af626x.stp
Numérisation/Librairies ST/STM8S_StdPeriph_Lib/Project/STM8S_StdPeriph_Template/STVD/Raisonance/stm8s007.stp
Numérisation/Librairies ST/STM8S_StdPeriph_Lib/Project/STM8S_StdPeriph_Template/STVD/Cosmic/stm8af52ax.stp
Numérisation/Librairies ST/STM8S_StdPeriph_Lib/Project/STM8S_StdPeriph_Template/STVD/Raisonance/stm8af622x.stp
Numérisation/Librairies ST/STM8S_StdPeriph_Lib/Project/STM8S_StdPeriph_Template/STVD/Cosmic/stm8s001.stp
Numérisation/Librairies ST/STM8S_StdPeriph_Lib/Project/STM8S_StdPeriph_Template/STVD/Raisonance/stm8s903.stp
Numérisation/Librairies ST/STM8S_StdPeriph_Lib/Project/STM8S_StdPeriph_Template/STVD/Cosmic/stm8s003.stp
Numérisation/Librairies ST/STM8S_StdPeriph_Lib/Project/STM8S_StdPeriph_Template/STVD/Raisonance/stm8s003.stp
Numérisation/Librairies ST/STM8S_StdPeriph_Lib/Project/STM8S_StdPeriph_Template/STVD/Cosmic/stm8s207.stp
Numérisation/Librairies ST/STM8S_StdPeriph_Lib/Project/STM8S_StdPeriph_Template/STVD/Raisonance/stm8s103.stp
Numérisation/Librairies ST/STM8S_StdPeriph_Lib/Project/STM8S_StdPeriph_Template/STVD/Cosmic/stm8s005.stp
Numérisation/Librairies ST/STM8S_StdPeriph_Lib/Project/STM8S_StdPeriph_Template/STVD/Raisonance/stm8af62ax.stp
Numérisation/Librairies ST/STM8S_StdPeriph_Lib/Project/STM8S_StdPeriph_Template/STVD/Cosmic/stm8s105.stp
Numérisation/Librairies ST/STM8S_StdPeriph_Lib/Project/STM8S_StdPeriph_Template/STVD/Raisonance/stm8s105.stp
Numérisation/Librairies ST/STM8S_StdPeriph_Lib/Project/STM8S_StdPeriph_Template/STVD/Cosmic/stm8s103.stp
Numérisation/Librairies ST/STM8S_StdPeriph_Lib/Project/STM8S_StdPeriph_Template/STVD/Raisonance/stm8s208.stp
Numérisation/Librairies ST/STM8S_StdPeriph_Lib/Project/STM8S_StdPeriph_Template/STVD/Cosmic/stm8s007.stp
Numérisation/Librairies ST/STM8S_StdPeriph_Lib/Project/STM8S_StdPeriph_Template/STVD/Raisonance/stm8s001.stp
Numérisation/Librairies ST/STM8S_StdPeriph_Lib/Project/STM8S_StdPeriph_Template/STVD/Cosmic/stm8af622x.stp
Numérisation/Librairies ST/STM8S_StdPeriph_Lib/Project/STM8S_StdPeriph_Template/STVD/Raisonance/stm8af626x.stp
Numérisation/Librairies ST/STM8S_StdPeriph_Lib/Project/STM8S_StdPeriph_Template/STVD/Cosmic/stm8s208.stp
Numérisation/Librairies ST/STM8S_StdPeriph_Lib/Project/STM8S_StdPeriph_Template/STVD/Raisonance/stm8s207.stp
Numérisation/Librairies ST/STM8S_StdPeriph_Lib/Project/STM8S_StdPeriph_Template/STVD/Cosmic/stm8af62ax.stp
Numérisation/Librairies ST/STM8S_StdPeriph_Lib/Project/STM8S_StdPeriph_Template/STVD/Raisonance/stm8s005.stp
