guillemotmoussu/PX222-EIS/Carnet de bord Rémi & Vincent/cr_auto.pdf

# PX211 Auto - Compte rendu Sustentation magnétique

### Vincent MOUCADEAU - Rémi MAZZONE — 2A

27/01/2023

## Table des matières

1 Découverte du projet | 2
2 Début du projet | 2
3 Idée : pilotage de l’alimentation par USB | 3
4 Etude du capteur Sharp | 6
5 Mesure des caractéristiques de la bobine | 6
6 Détermination de la fonction de transfert | 6

## 1 Découverte du projet

L’objectif principal du projet est de trouver une manière de faire sustenter une bille à l’aide d’une bobine, commandée par un système automatique. L’idée est d’utiliser un capteur infrarouge ”Sharp” pour que la distance entre la bille et la bobine soit constante, sans la toucher. Pour le premier semestre, le but est de déterminer la fonction de transfert du système global (bobine et bille).
Voici un schéma permettant d’illustrer le projet :

Bobine

Bille

Capteur

## 2 Début du projet

Nous avons commencé par nous familiariser avec le matériel à disposition :

| Une bobine avec noyau mobile
| Une bille en acier d’environ 35,8g
| Un portique pour installer la bobine

Nous avons donc installé la bobine sur le portique et utilisé l’alimentation DC en mode CC/CV pour régler le courant dans la bobine. Cela a pour effet de créer un champ magnétique plus ou moins fort qui attire la bille vers le noyau de la bobine. Nous avons donc mesuré le courant nécessaire pour que la bille décolle pour différentes distances, de 1mm à 23mm. Nous obtenons le tableau suivant :

Tension | Courant | Distance minimale bille | Rbobine
8,612 | 0,647 | 1mm | 13,31Ω
11,296 | 0,847 | 5mm | 13,34Ω
13,96 | 1,047 | 8mm | 13,33Ω
16,623 | 1,247 | 14mm | 13,33Ω
19,293 | 1,447 | 15mm | 13,33Ω
21,962 | 1,647 | 19mm | 13,33Ω
24,65 | 1,847 | 20mm | 13,35Ω
27,34 | 2,047 | 22mm | 13,36Ω
29,915 | 2,247 | 23mm | 13,31Ω

Graphique :

0 | 5 | 10 | 15 | 20 | 25

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
Distance bille [mm]

Courant [A]

Distance minimale bille en fonction du courant

d = f(I)

## 3 Idée : pilotage de l’alimentation par USB

Dans l’optique de réguler la distance entre la bille et la bobine, il faut pouvoir contrôler le courant traversant la bobine. Nous avons donc eu l’idée d’essayer de contrôler l’alimentation de la salle de TP avec le port USB situé à l’arrière de celle-ci. En effet, si cette méthode est convaincante, il suffirait d’acquérir la tension du capteur Sharp avec un ADC (Analog to Digital Converter) et un algorithme de type PID permettrait de corriger la position de la bille (solution numérique donc).

Nous avons donc cherché le manuel de l’alimentation RIGOL afin de comprendre comment lui envoyer des requêtes. Il faut en fait utiliser des instructions SCPI (Standard Commands for Programmable Instruments) pour communiquer avec l’alimentation. Par exemple, la commande

:INST CH1 permet de choisir le canal à utiliser (de CH1 à CH3) et :CURR 0.4 permet de définir la limite de courant à 0, 4A.
Au début, nous rentrions les commandes à la main dans le logiciel de l’alimentation :


Cependant, nous avons vite compris que cela n’était pas très pratique. Nous avons donc décidé d’utiliser un script Python pour envoyer les commandes à l’alimentation. Nous avons utilisé la librairie PyVISA pour communiquer avec l’alimentation. Voici un exemple de script Python qui permet de changer la limite de courant toutes les secondes :

import pyvisa
import time

resources = pyvisa.ResourceManager()

psu = resources.open_resource(resources.list_resources()[0]) psu.write(":INST CH1")
while 1:
psu.write(":CURR 0.4")
time.sleep(1)
psu.write(":CURR 0.2")
time.sleep(1)

Voyant que la commutation entre les deux valeurs de courant pouvait être rapide, nous avons voulu utiliser l’oscilloscope pour vérifier la qualité de l’asservissement de l’alimentation. Voici le résultat (tension en jaune, courant en bleu) :

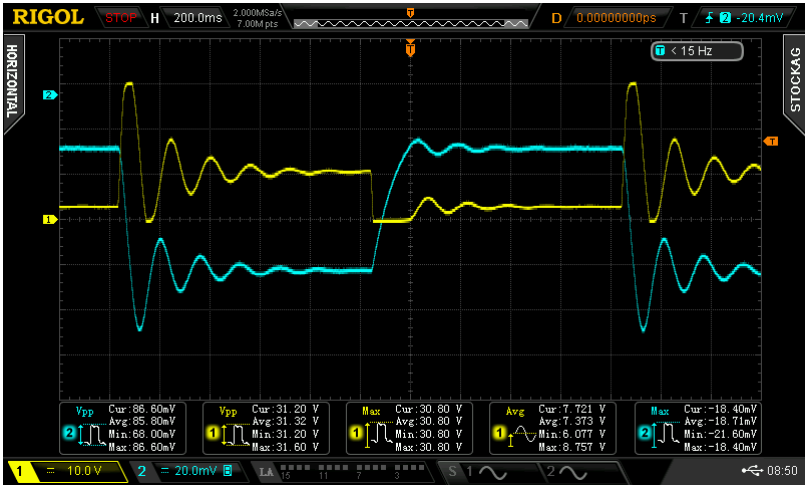
[picture p39: figure]

On remarque que la commutation se fait bien mais qu’il y a trop d’oscilations. Cela pourrait causer la chutte de la bille. Nous ne pouvons donc pas utiliser cette méthode pour contrôler le courant de la bobine. Nous avons aussi essayé de contrôler la tension de l’alimentation mais les résultats sont similaires.

## 4 Etude du capteur Sharp

Afin de déterminer la distance entre la bille et la bobine, nous avons utilisé un capteur Sharp GP2Y0A21YK0F. Ce capteur est un capteur de distance infrarouge qui renvoie une tension représentant la distance entre le capteur et un obstacle. Nous avons donc mesuré la tension de sortie du capteur à l’aide du multimètre et nous avons fait varier la distance entre la bille et le capteur (pas de 0,5mm). Comme la distance entre un obstacle et le capteur est comprise entre 4 et 8mm, nous avons décidé de faire une régression linéaire sur les points de la courbe entre 4 et 8cm. Voici le résultat :
Distance par rapport à la tension de sortie du capteur Sharp

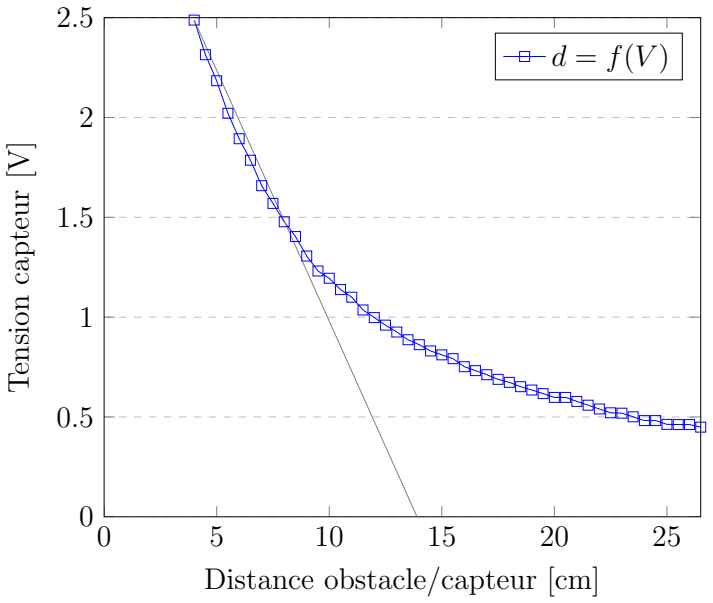
[picture p40: figure]
Distance obstacle/capteur [cm]; Tension capteur [V]

On obtient donc le modèle linéaire suivant : d = −4, 10u + 13, 9 avec d en cm et u en V.

## 5 Mesure des caractéristiques de la bobine

Avec nos mesures en courant continu, nous avons pu déterminer la résistance interne de la bobine. Celle-ci vaut en moyenne 13, 33Ω. Afin de déterminer l’inductance réelle de la bobine, nous avons utilisé le générateur basse fréquence (amplitude de 1,6V crête, fréquence de 2Hz) pour identifier le déphasage induit par la bobine à l’aide de l’oscilloscope (environ 60ms ou −0, 75 rad). Calculons l’inductance de la bobine :
Z = R + jLω = 13, 33 + jLω et arctan Lω
R
= 0, 75

L =

R tan(0, 75)
ω

= 0, 98 H

## 6 Détermination de la fonction de transfert

A l’aide d’Hopkinson, nous avons pu déterminer l’inductance L en fonction de la position de la

bille : L(z) = L0 +

L1
1 + αz

. Nous avons déjà déterminé la valeur de L0 = 0, 98H (inductance de la bobine sans bille). En appliquant le principe fondamental de la dynamique, nous avons :

−→
F +

−→
P = m

−→
a
Sur l’axe −→
z : − F(z) + mg = mz¨

On remarque que l’équation différentielle n’est pas linéaire :

I

2L1α
2(1 + αz)

2

+ mg = 0

On linéarise avec Taylor autour de (z0, I0) :

F(z, I) ≈ F(z0, I0) + dF

dz (z − z0) + dF
di (I − I0)

On note ∂F
∂I =

I0L1α
(1 + αz0)

2

= ki et

∂F
∂z =

I

2
0L1α

2
(1 + αz0)

3

= −kz

En choisissant z0 quand la bille est à l’équilibre, on a F(z0, I0) + mg = 0, la force magnétique compense le poids de la bille. On a donc :

I

2
0L1α
2(1 + αz0)

2

= mg

Nous pouvons maintenant utiliser les mesures effectuées au début du projet (distance minimale pour le décollage de la bille par rapport au courant) pour trouver L1 et α. En linéarisant, on

obtient a =

r
L1
2αmg

et b =

1
α

. On utilise Regressi pour trouver les valeurs de a et b :

a = 0, 0682
b = 0, 485

Donc L1 = 6, 73H et α = 2, 06 et L(z) = 1 + 6, 73 1 + 2, 03z

Ainsi, on a F(z, I) ≈ F(z0, I0) +ki(I −I0)−kz(z −z0) ≈ F(z0, I0) +kiI −kzz car z ≈ z0 et I ≈ I0. Donc on a :

mg − F(z0, I0) − kiI + kzz = mz¨ −kiI(t) + kzz(t) = mz¨ car mg − F(z0, I0) = 0

On applique la transformée de Laplace :

−kiI(p) = (kz + mp²
)z(p)

On obtient donc la fonction de transfert :

H(p) = z(p)
I(p)

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
