guillemotmoussu/PX222-EIS/Carnet de bord Rémi & Vincent/picture/python_program.png

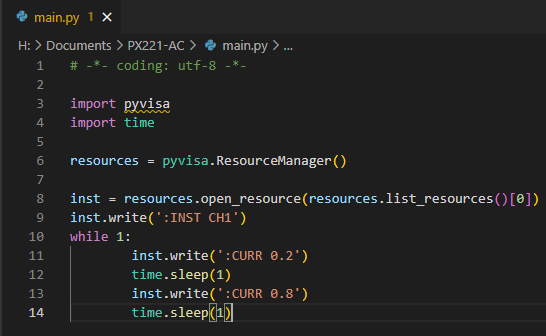
Carnet de bord Rémi & Vincent/picture/python_program.png
