guillemotmoussu/PX222-EIS/Carnet de bord Rémi & Vincent/picture/regressi.PNG

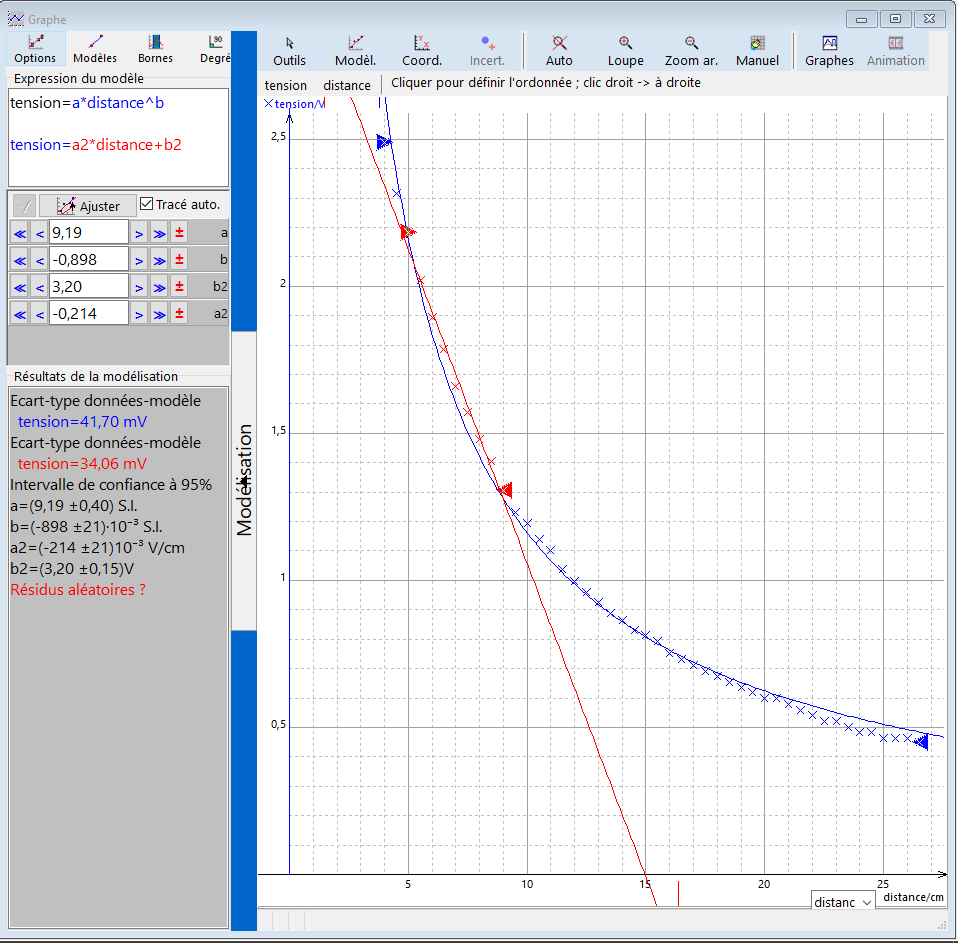
Carnet de bord Rémi & Vincent/picture/regressi.PNG
