guillemotmoussu/PX222-EIS/Carnet de bord Rémi & Vincent/picture/ultra_sigma_home.PNG

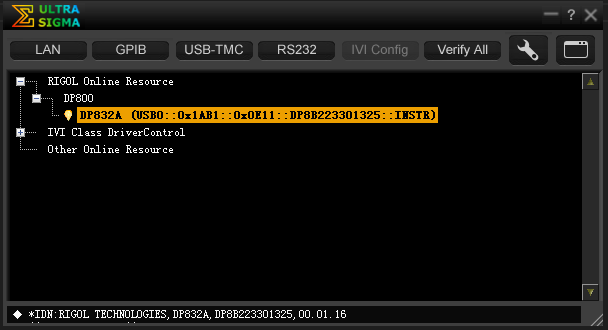
Carnet de bord Rémi & Vincent/picture/ultra_sigma_home.PNG
