guillemotmoussu/PX222-EIS/LTspice/snom211b/lm741-PSpiceFiles/SCHEMATIC1/transient/Transient.cir

** Profile: "SCHEMATIC1-Transient"  [ C:\Users\a0488299\Desktop\Applications Rotation\PFTI- renaming 30 models\PSPICE Rename\LM741\LM741-PSpiceFiles\SCHEMATIC1\Transient.sim ] 

** Creating circuit file "Transient.cir" 
** WARNING: THIS AUTOMATICALLY GENERATED FILE MAY BE OVERWRITTEN BY SUBSEQUENT SIMULATIONS

*Libraries: 
* Profile Libraries :
* Local Libraries :
.LIB "../../../lm741.lib" 
* From [PSPICE NETLIST] section of C:\cds_spb_home\cdssetup\OrCAD_PSpiceTIPSpice_Install\17.4.0\PSpice.ini file:
.lib "nom_pspti.lib" 
.lib "nom.lib" 

*Analysis directives: 
.TRAN  0 1m 0 
.OPTIONS ADVCONV
.OPTIONS FILEMODELSEARCH
.PROBE64 N([N00436])
.PROBE64 N([N00506])
.INC "..\SCHEMATIC1.net" 


.END
