guillemotmoussu/PX222-EIS/LTspice/Ampli.asc

D1: diode
L1: ind; 0.98
Q1: npn
R1: res; 1000
R2: res; 5100
R3: res; 13.3
U1: LT1001
V1: voltage; PULSE(0 5 0.2 0 0 0.1 0.2 10)
V2: voltage; 30
Named nets: 0, out, in
.tran 1
