guillemotmoussu/PX222-EIS/(list of files, drawings)

Other design files:
Fritzing/Amplificateur.fzz
Fritzing/coucou.fzz
Fritzing/Modèle complet PD.fzz
Fritzing/Régulateur PD.fzz
Fritzing/Régulateur PID.fzz
LTspice/snom211b/lm741.dsn
LTspice/snom211b/lm741.opj
