guillemotmoussu/PX222-EIS/Numérisation/Librairies ST/STM8S_StdPeriph_Lib/Project/STM8S_StdPeriph_Template/main.c

/**
  ******************************************************************************
  * @file    Project/main.c 
  * @author  MCD Application Team
  * @version V2.3.0
  * @date    16-June-2017
  * @brief   Main program body
   ******************************************************************************
  * @attention
  *
  * <h2><center>&copy; COPYRIGHT 2014 STMicroelectronics</center></h2>
  *
  * Licensed under MCD-ST Liberty SW License Agreement V2, (the "License");
  * You may not use this file except in compliance with the License.
  * You may obtain a copy of the License at:
  *
  *        http://www.st.com/software_license_agreement_liberty_v2
  *
  * Unless required by applicable law or agreed to in writing, software 
  * distributed under the License is distributed on an "AS IS" BASIS, 
  * WITHOUT WARRANTIES OR CONDITIONS OF ANY KIND, either express or implied.
  * See the License for the specific language governing permissions and
  * limitations under the License.
  *
  ******************************************************************************
  */ 


/* Includes ------------------------------------------------------------------*/
#include "stm8s.h"

/* Private defines -----------------------------------------------------------*/
/* Private function prototypes -----------------------------------------------*/
/* Private functions ---------------------------------------------------------*/

void main(void)
{
  /* Infinite loop */
  while (1)
  {
  }
  
}

#ifdef USE_FULL_ASSERT

/**
  * @brief  Reports the name of the source file and the source line number
  *   where the assert_param error has occurred.
  * @param file: pointer to the source file name
  * @param line: assert_param error line source number
  * @retval : None
  */
void assert_failed(u8* file, u32 line)
{ 
  /* User can add his own implementation to report the file name and line number,
     ex: printf("Wrong parameters value: file %s on line %d\r\n", file, line) */

  /* Infinite loop */
  while (1)
  {
  }
}
#endif


/************************ (C) COPYRIGHT STMicroelectronics *****END OF FILE****/
