guillemotmoussu/PX222-EIS/Numérisation/Librairies ST/STM8S_StdPeriph_Lib/Project/STM8S_StdPeriph_Examples/TIM1/TIM1_Sinewave_Generation/main.h

/**
  ******************************************************************************
  * @file    TIM1_Sinewave_Generation\main.h
  * @author  MCD Application Team
  * @version V2.0.4
  * @date    26-April-2018
  * @brief   This file contains the defines for TIM1 Sinewave Generation example.
  ******************************************************************************
  * @attention
  *
  * <h2><center>&copy; COPYRIGHT 2014 STMicroelectronics</center></h2>
  *
  * Licensed under MCD-ST Liberty SW License Agreement V2, (the "License");
  * You may not use this file except in compliance with the License.
  * You may obtain a copy of the License at:
  *
  *        http://www.st.com/software_license_agreement_liberty_v2
  *
  * Unless required by applicable law or agreed to in writing, software 
  * distributed under the License is distributed on an "AS IS" BASIS, 
  * WITHOUT WARRANTIES OR CONDITIONS OF ANY KIND, either express or implied.
  * See the License for the specific language governing permissions and
  * limitations under the License.
  *
  ******************************************************************************
  */ 

/* Includes ------------------------------------------------------------------*/
#include "stm8s.h"

/* Private define ------------------------------------------------------------*/
#define FREQ_65_3595
/* #define FREQ_65_3083 */
/* #define FREQ_65_2316 */
/* #define FREQ_65_2061 */
/* #define FREQ_65_1890 */
/* #define FREQ_65_1042 */
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
#endif

#ifdef FREQ_51_0308
       #define       nbr_of_samples_half 46
       #define       COUNTER             4
       #define       INIT_TIM1_ARR       0xD4
       #define       INIT_TIM1_CCR1      0x6A
       #define       AVERAGE_AMP         0x6A
#endif

#ifdef FREQ_50_9580
       #define       nbr_of_samples_half 16
       #define       COUNTER             11
       #define       INIT_TIM1_ARR       0xDE
       #define       INIT_TIM1_CCR1      0x6F
       #define       AVERAGE_AMP         0x6F
#endif

#ifdef FREQ_50_8751
       #define       nbr_of_samples_half 26
       #define       COUNTER             6
       #define       INIT_TIM1_ARR       0xFB
       #define       INIT_TIM1_CCR1      0x7D
       #define       AVERAGE_AMP         0x7D
#endif

#ifdef FREQ_50_7924
       #define       nbr_of_samples_half 46
       #define       COUNTER             4
       #define       INIT_TIM1_ARR       0xD5
       #define       INIT_TIM1_CCR1      0x6A
       #define       AVERAGE_AMP         0x6A
#endif

#ifdef FREQ_50_7305
       #define       nbr_of_samples_half 16
       #define       COUNTER             11
       #define       INIT_TIM1_ARR       0xDF
       #define       INIT_TIM1_CCR1      0x6F
       #define       AVERAGE_AMP         0x6F
#endif

#ifdef FREQ_50_6586
       #define       nbr_of_samples_half 24
       #define       COUNTER             7
       #define       INIT_TIM1_ARR       0xEA
       #define       INIT_TIM1_CCR1      0x75
       #define       AVERAGE_AMP         0x75
#endif

#ifdef FREQ_50_5663
       #define       nbr_of_samples_half 24
       #define       COUNTER             8
       #define       INIT_TIM1_ARR       0xCD
       #define       INIT_TIM1_CCR1      0x66
       #define       AVERAGE_AMP         0x66
#endif

#ifdef FREQ_50_5051
       #define       nbr_of_samples_half 16
       #define       COUNTER             11
       #define       INIT_TIM1_ARR       0xE0
       #define       INIT_TIM1_CCR1      0x70
       #define       AVERAGE_AMP         0x70
#endif

#ifdef FREQ_50_4439
       #define       nbr_of_samples_half 24
       #define       COUNTER             7
       #define       INIT_TIM1_ARR       0xEB
       #define       INIT_TIM1_CCR1      0x75
       #define       AVERAGE_AMP         0x75
#endif

#ifdef FREQ_50_4032
       #define       nbr_of_samples_half 16
       #define       COUNTER             10
       #define       INIT_TIM1_ARR       0xF7
       #define       INIT_TIM1_CCR1      0x7B
       #define       AVERAGE_AMP         0x7B
#endif

#ifdef FREQ_50_3221
       #define       nbr_of_samples_half 24
       #define       COUNTER             8
       #define       INIT_TIM1_ARR       0xCE
       #define       INIT_TIM1_CCR1      0x67
       #define       AVERAGE_AMP         0x67
#endif

#ifdef FREQ_50_2311
       #define       nbr_of_samples_half 24
       #define       COUNTER             7
       #define       INIT_TIM1_ARR       0xEC
       #define       INIT_TIM1_CCR1      0x76
       #define       AVERAGE_AMP         0x76
#endif

#ifdef FREQ_50_1781
       #define       nbr_of_samples_half 26
       #define       COUNTER             7
       #define       INIT_TIM1_ARR       0xDA
       #define       INIT_TIM1_CCR1      0x6D
       #define       AVERAGE_AMP         0x6D
#endif

#ifdef FREQ_50_0801
       #define       nbr_of_samples_half 24
       #define       COUNTER             8
       #define       INIT_TIM1_ARR       0xCF
       #define       INIT_TIM1_CCR1      0x67
       #define       AVERAGE_AMP         0x67
#endif

#ifdef FREQ_50_0200
       #define       nbr_of_samples_half 24
       #define       COUNTER             7
       #define       INIT_TIM1_ARR       0xED
       #define       INIT_TIM1_CCR1      0x76
       #define       AVERAGE_AMP         0x76
#endif

#ifdef FREQ_49_9500
       #define       nbr_of_samples_half 26
       #define       COUNTER             7
       #define       INIT_TIM1_ARR       0xDB
       #define       INIT_TIM1_CCR1      0x6D
       #define       AVERAGE_AMP         0x6D
#endif

#ifdef FREQ_49_8604
       #define       nbr_of_samples_half 46
       #define       COUNTER             4
       #define       INIT_TIM1_ARR       0xD9
       #define       INIT_TIM1_CCR1      0x6C
       #define       AVERAGE_AMP         0x6C
#endif

#ifdef FREQ_49_8107
       #define       nbr_of_samples_half 24
       #define       COUNTER             7
       #define       INIT_TIM1_ARR       0xEE
       #define       INIT_TIM1_CCR1      0x77
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
#endif

#ifdef FREQ_44_9843
       #define       nbr_of_samples_half 30
       #define       COUNTER             6
       #define       INIT_TIM1_ARR       0xF6
       #define       INIT_TIM1_CCR1      0x7B
       #define       AVERAGE_AMP         0x7B
#endif

#ifdef FREQ_44_8934
       #define       nbr_of_samples_half 22
       #define       COUNTER             9
       #define       INIT_TIM1_ARR       0xE0
       #define       INIT_TIM1_CCR1      0x70
       #define       AVERAGE_AMP         0x70
#endif


/* Private typedef -----------------------------------------------------------*/
typedef struct {
  uint8_t Value[nbr_of_samples_half];
  uint8_t Index;
  bool Up;
}MySin_Typedef;



/*** (c) 2008   STMicroelectronics ****************** END OF FILE ************/
