guillemotmoussu/PX222-EIS/(commit log)

2023-03-26 Carnet de bord v0
2023-04-05 fin de séance
    [coucou.fzz]
2023-04-11 Travail entre séances 1 et 2
    [Amplificateur.fzz, Modèle complet PD.fzz, Régulateur PD.fzz, Régulateur PID.fzz, coucou.fzz, lm741.dsn, lm741.opj]
2023-04-19 compte rendu séance 2
    [Modèle complet PD.fzz]
2023-06-02 séance 3
    [stm8af52ax.stp, stm8af622x.stp, stm8af626x.stp, stm8af62ax.stp, stm8s001.stp, stm8s003.stp, stm8s005.stp, stm8s007.stp]
